shaunfg/MarsRoverElectronics/old-rover/lessr/PDFs/Rover-brd.pdf

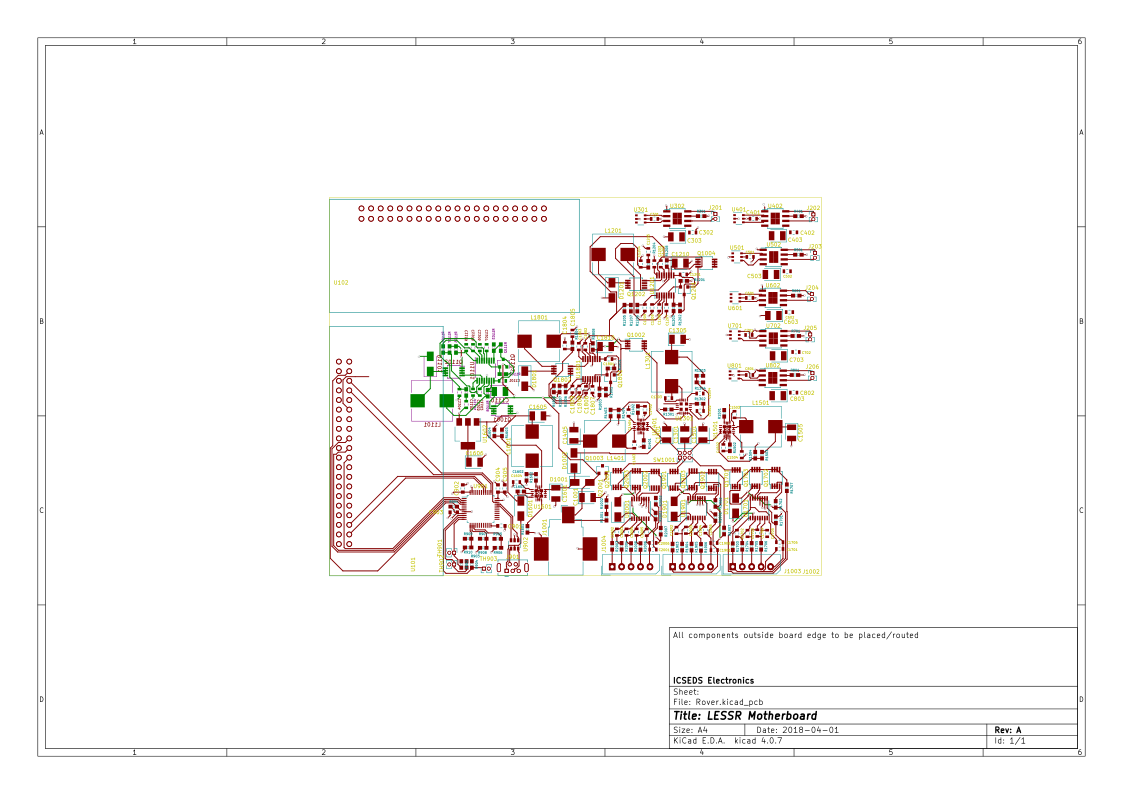
[picture p1: page 1]
