shaunfg/MarsRoverElectronics/Mars Rover.pdf

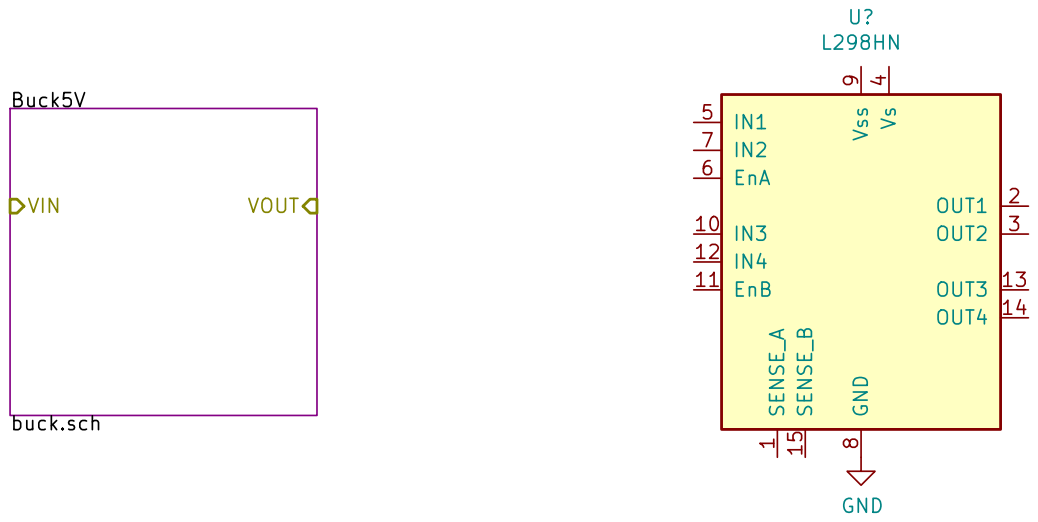
[picture p2: page 1]

Id: 1/2 Title: File: Mars Rover.sch Sheet: / SENSE_A

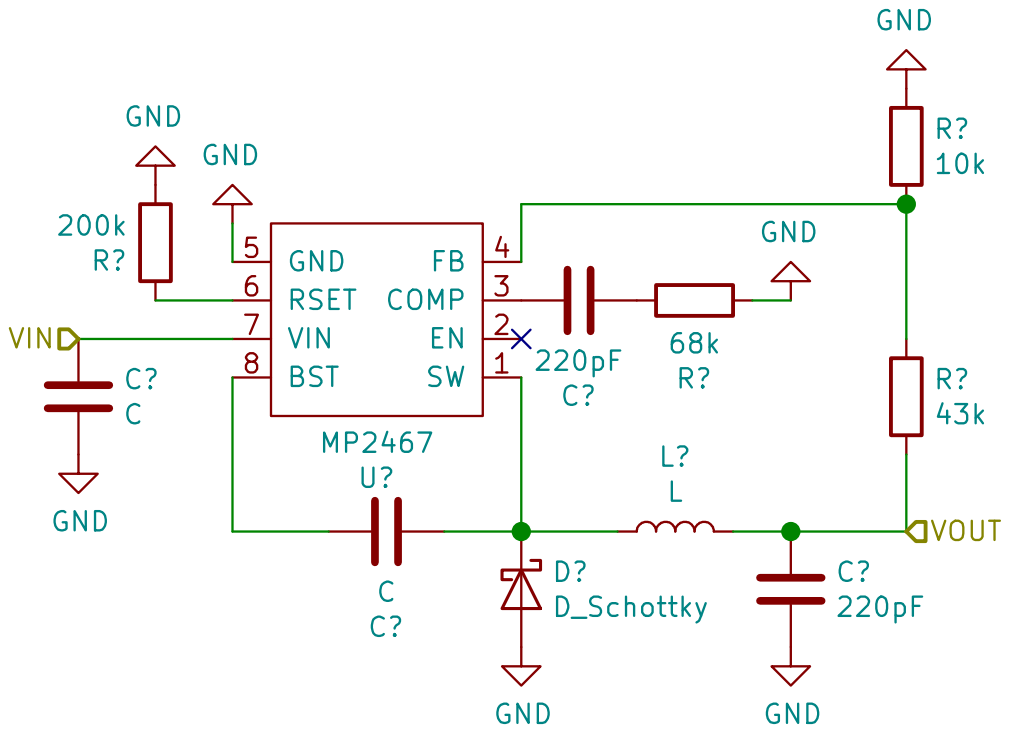
[picture p3: page 2]

Id: 2/2 Title: File: buck.sch Sheet: /Buck5V/
