shaunfg/MarsRoverElectronics/Gerbplots/Mars Rover-F.Cu.pdf

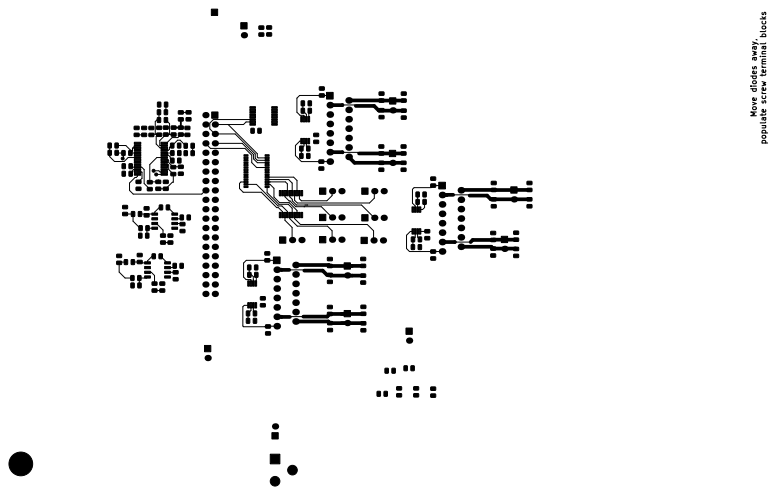
[picture p4: page 1]

Move diodes away, populate screw terminal blocks
