shaunfg/MarsRoverElectronics/Gerbplots/Mars Rover-B.Cu.pdf

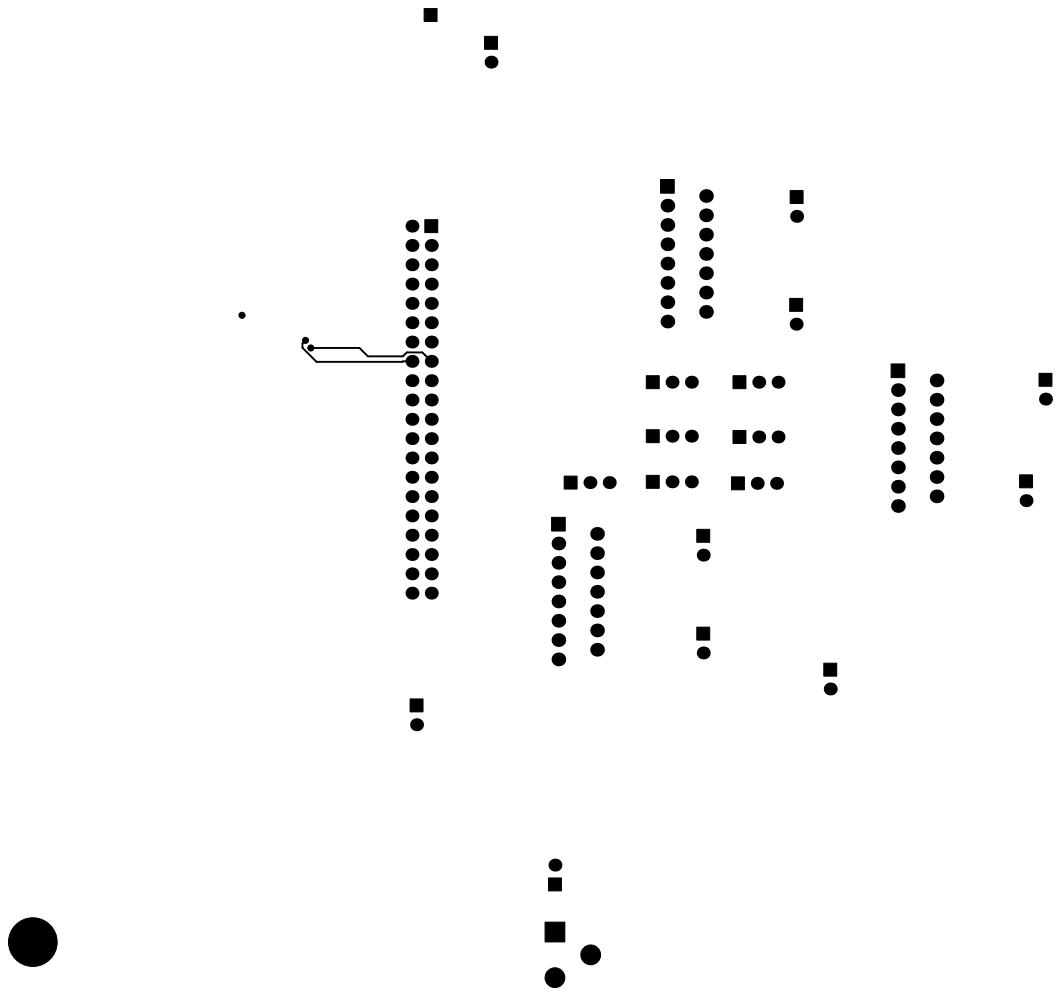
[picture p5: page 1]
