shaunfg/MarsRoverElectronics/Gerbplots/Mars Rover-B.Mask.pdf

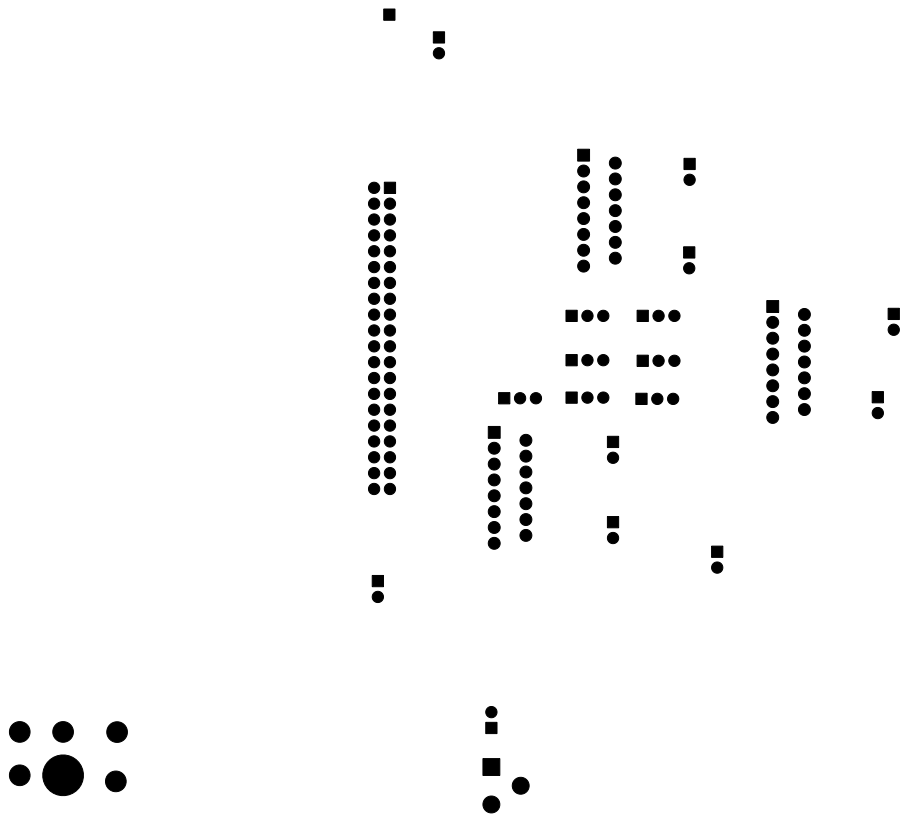
[picture p6: page 1]
