shaunfg/MarsRoverElectronics/Gerbplots/Mars Rover-F.Mask.pdf

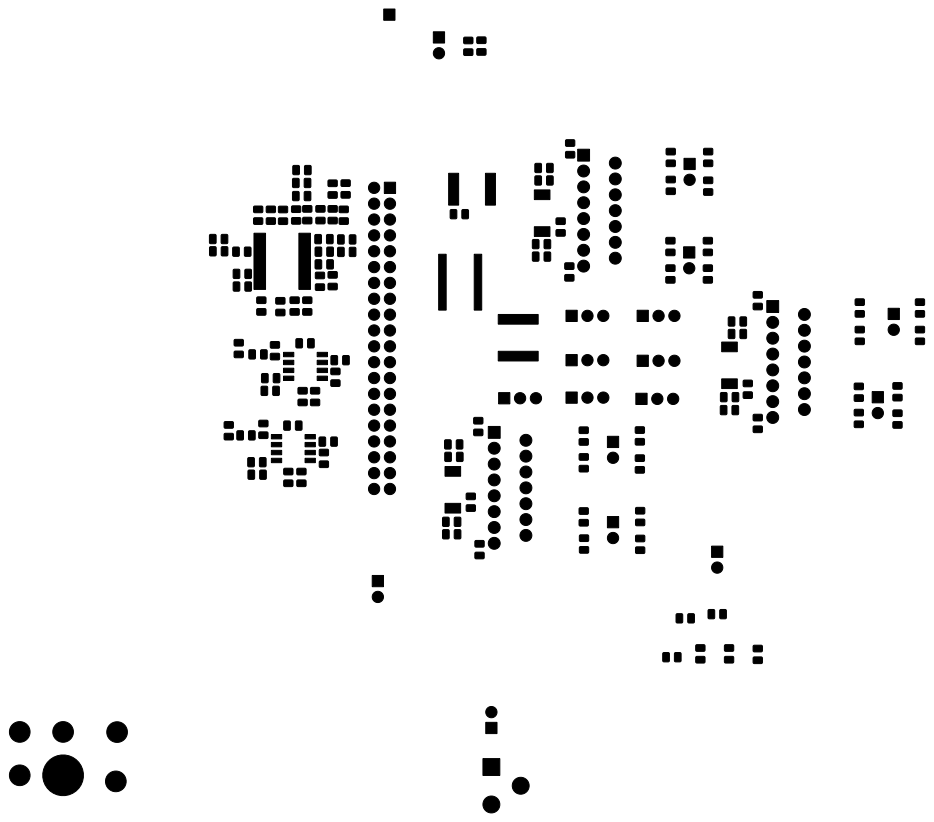
[picture p7: page 1]
