shaunfg/MarsRoverElectronics/Gerbplots/Mars Rover-F.Paste.pdf

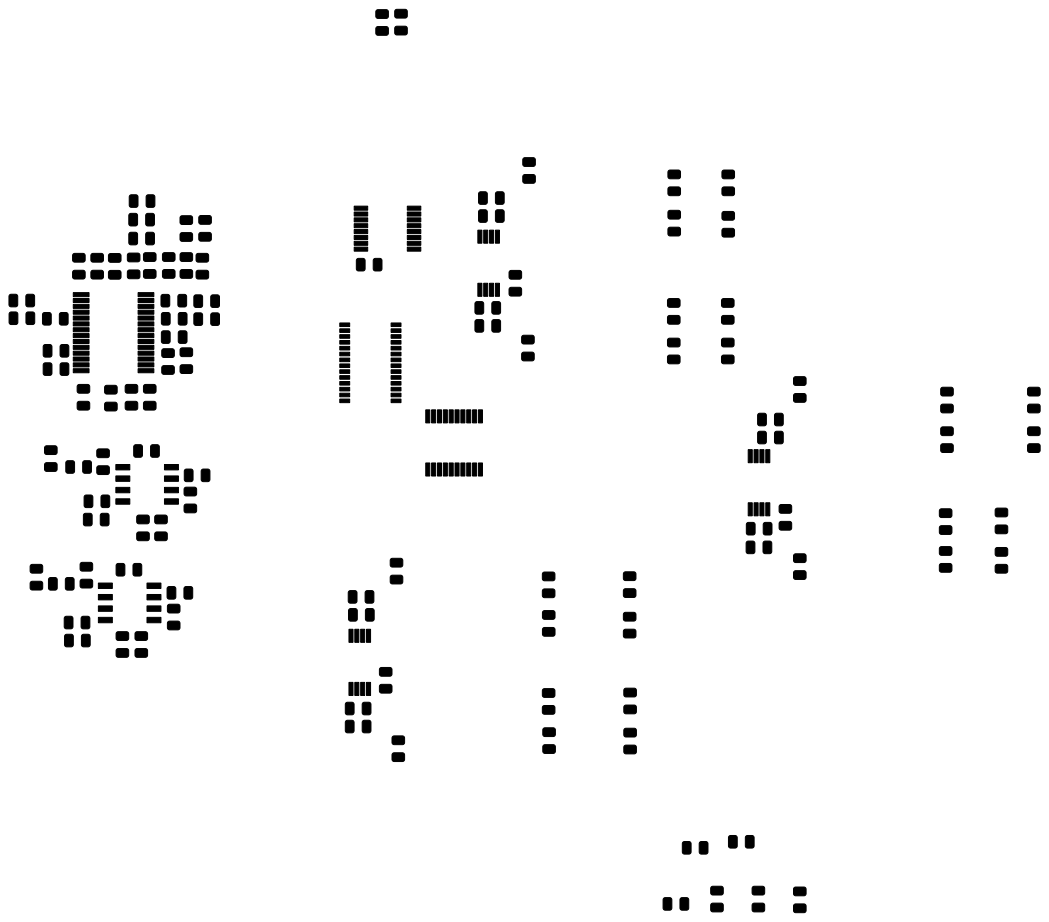
[picture p8: page 1]
