shaunfg/MarsRoverElectronics/Gerbplots/Mars Rover-F.SilkS.pdf

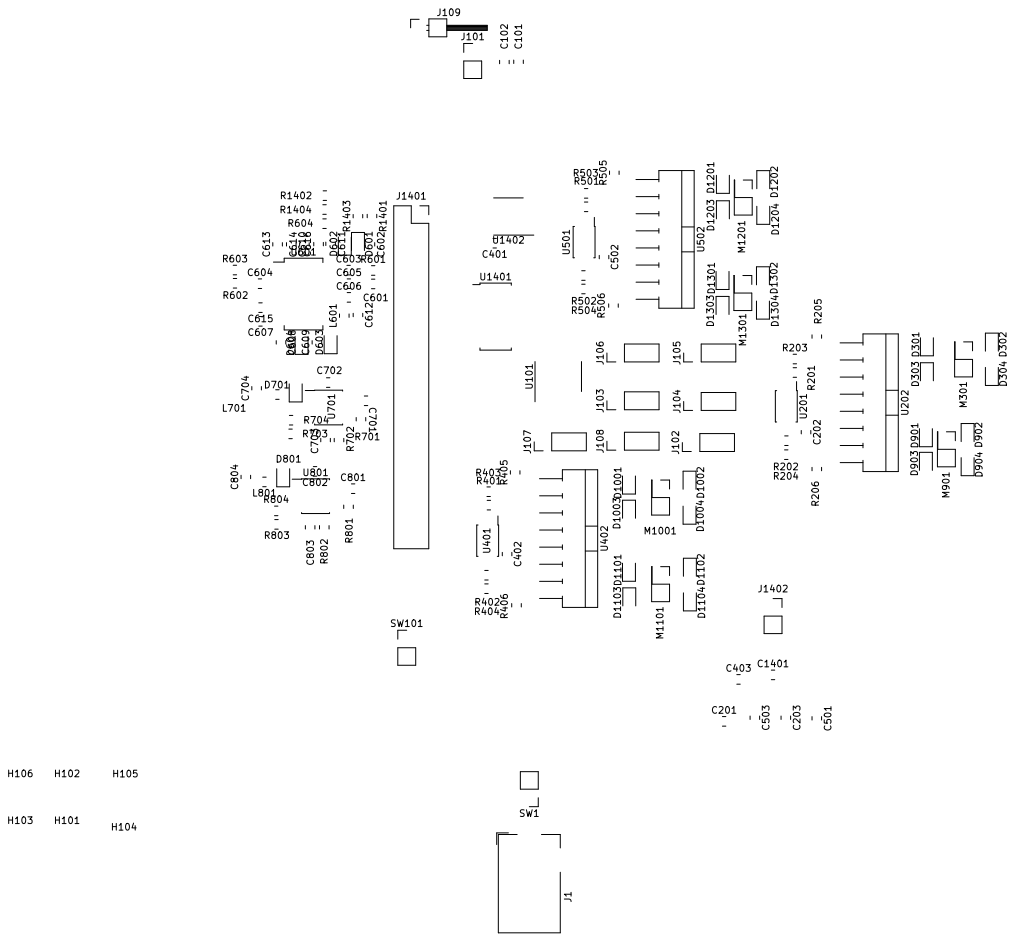
[picture p9: page 1]
