shaunfg/MarsRoverElectronics/old-rover/lessr/PDFs/layout.pdf

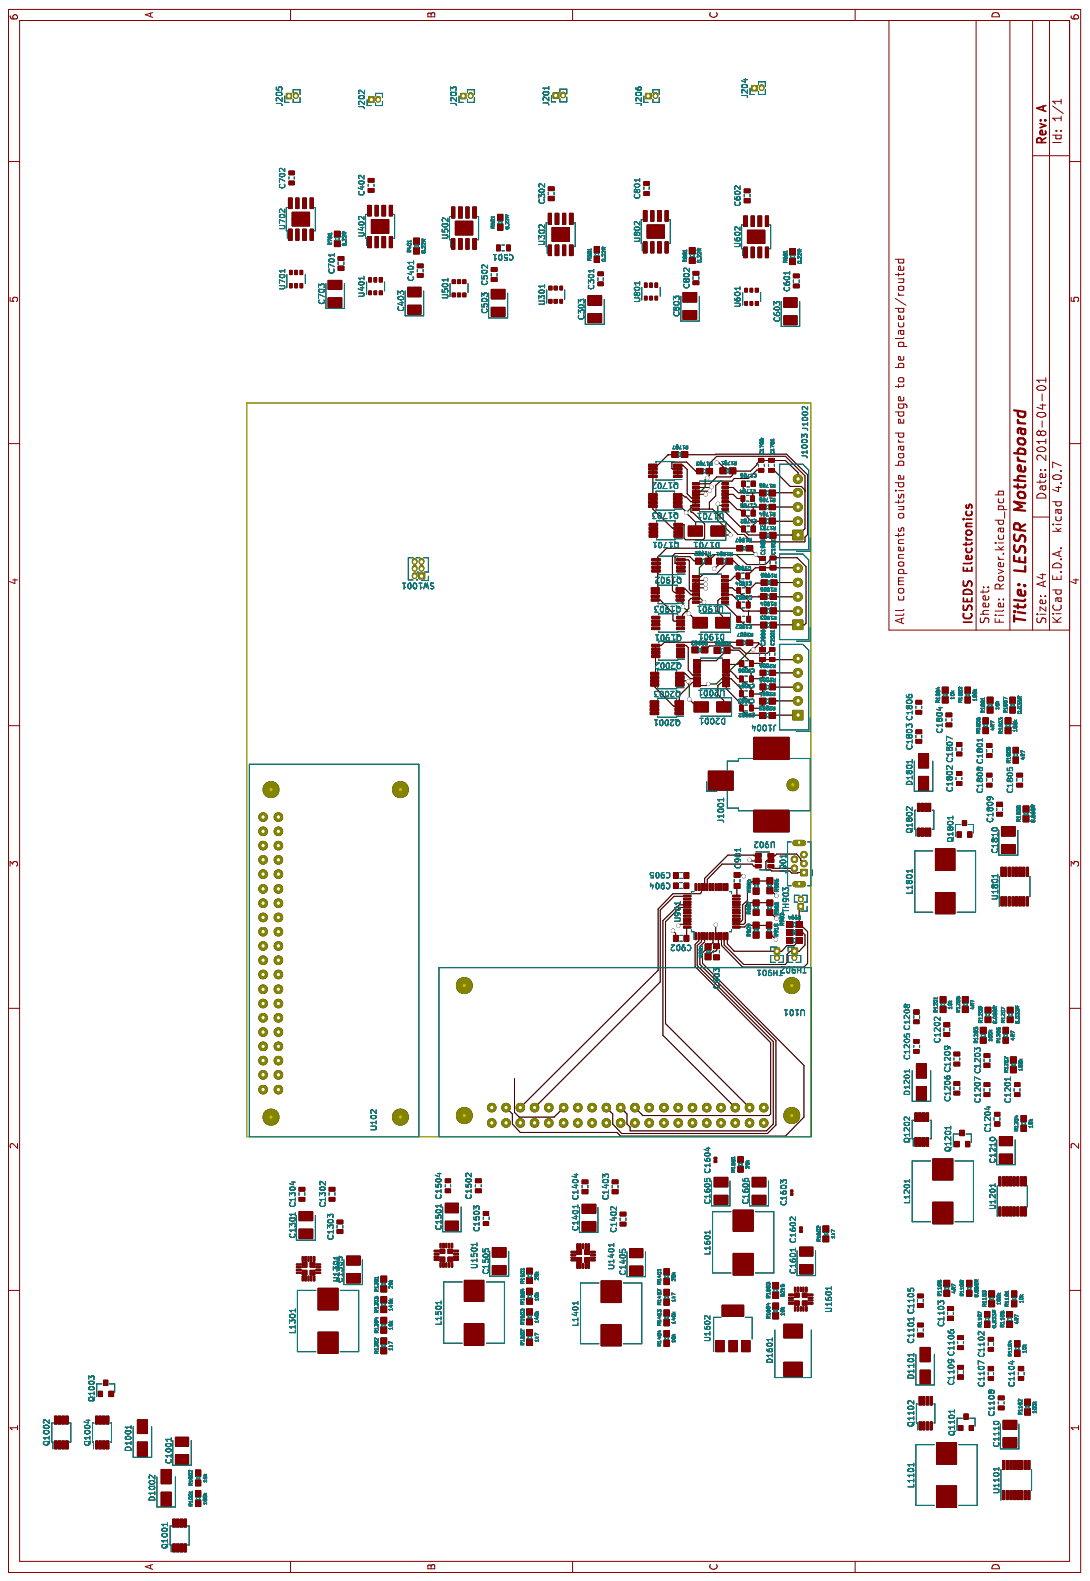
[picture p10: page 1]
