shaunfg/MarsRoverElectronics/old-rover/lessr/PDFs/Rover-B.Cu.pdf

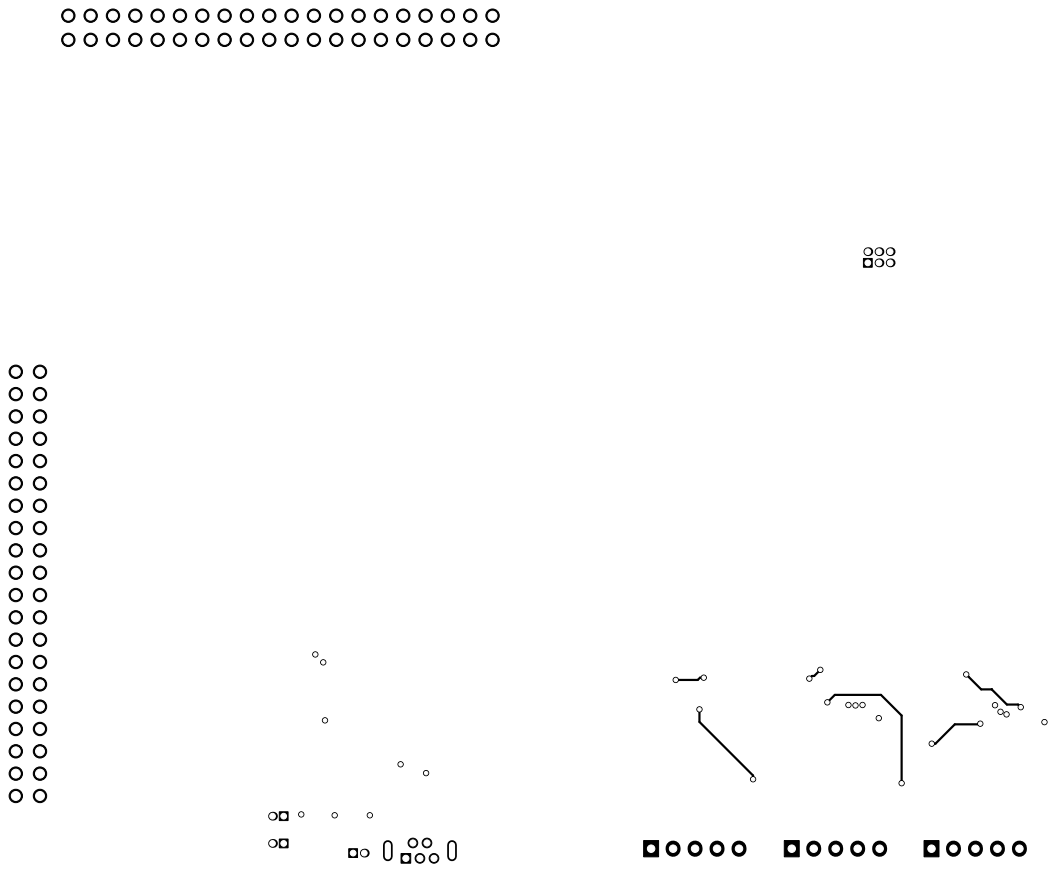
[picture p11: page 1]
