shaunfg/MarsRoverElectronics/old-rover/lessr/PDFs/Rover-Dwgs.User.pdf

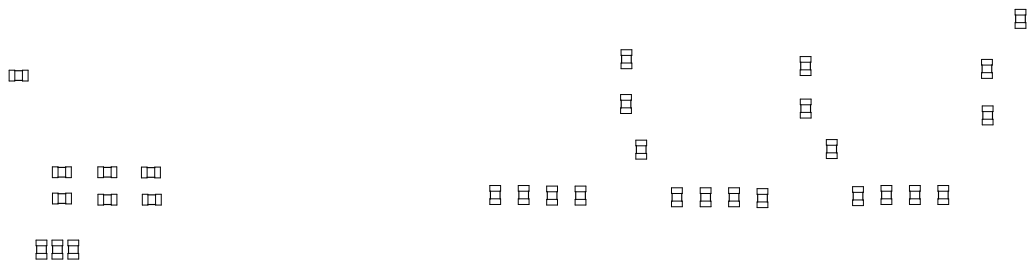
[picture p12: page 1]
