shaunfg/MarsRoverElectronics/old-rover/lessr/PDFs/Rover-F.Cu.pdf

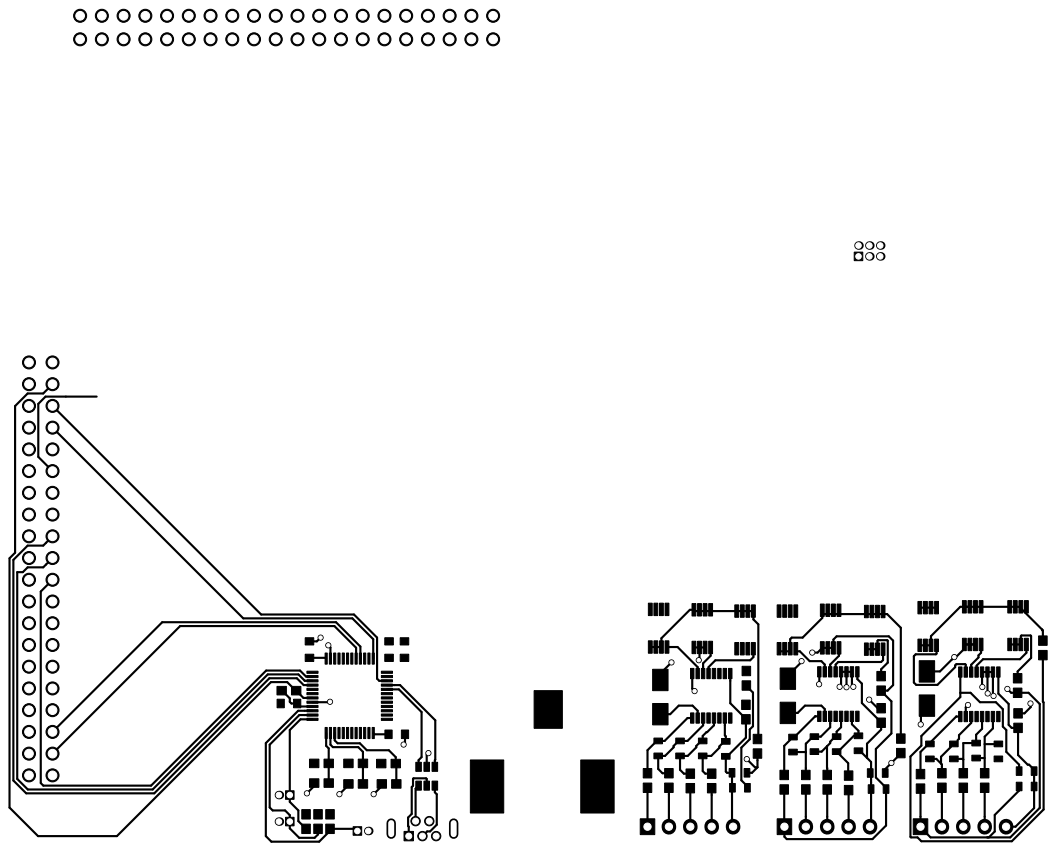
[picture p13: page 1]
