shaunfg/MarsRoverElectronics/old-rover/lessr/PDFs/Rover-F.SilkS.pdf

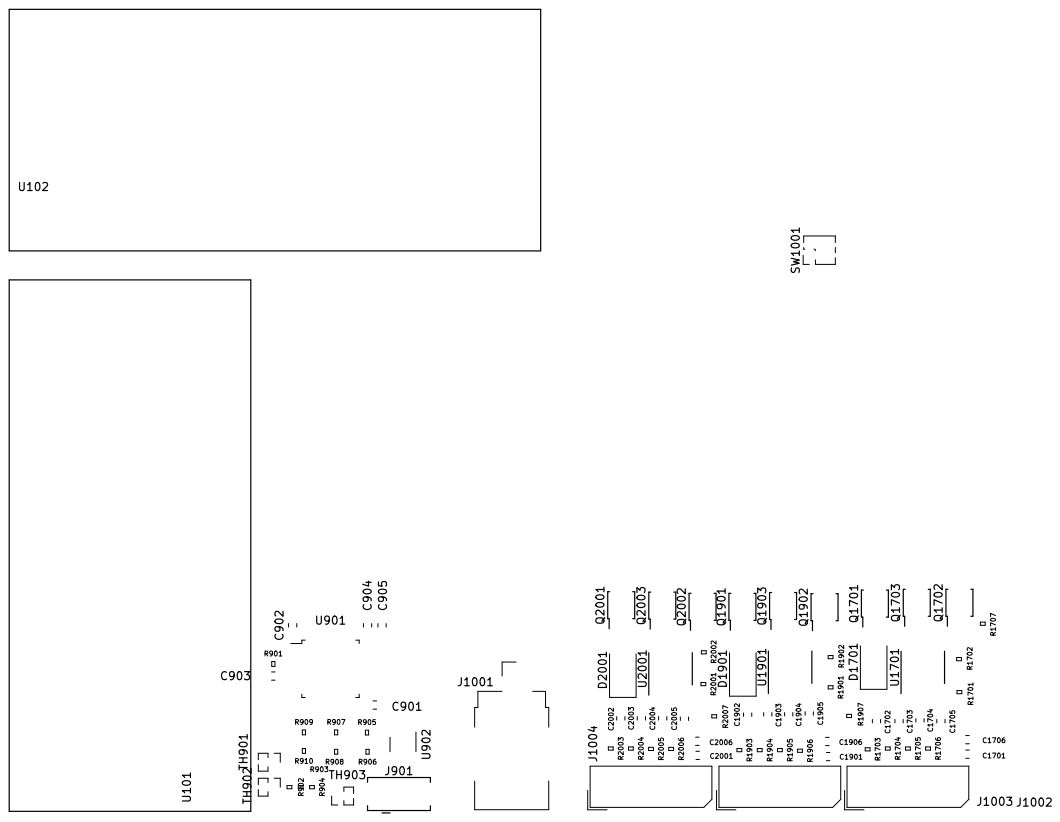
[picture p14: page 1]
