shaunfg/MarsRoverElectronics/old-rover/lessr/PDFs/Rover.pdf

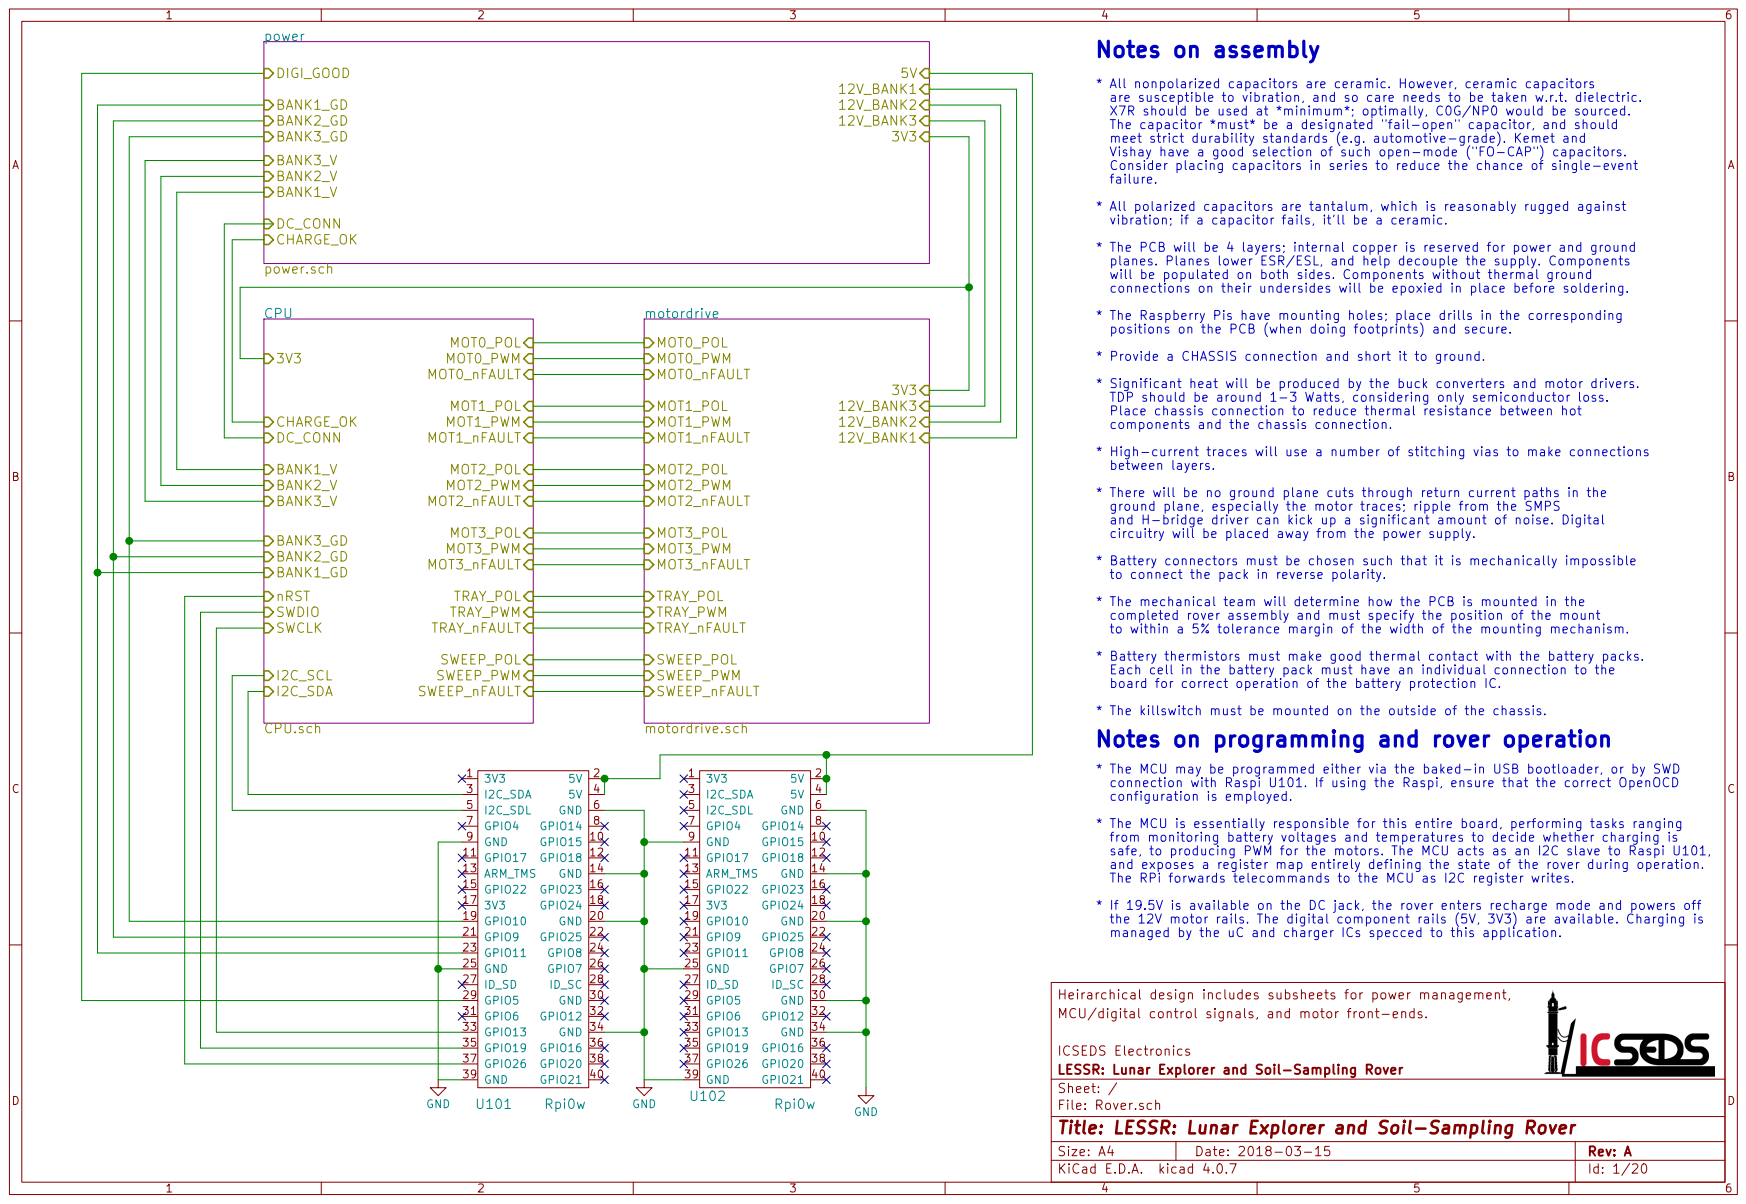
[picture p15: page 1]

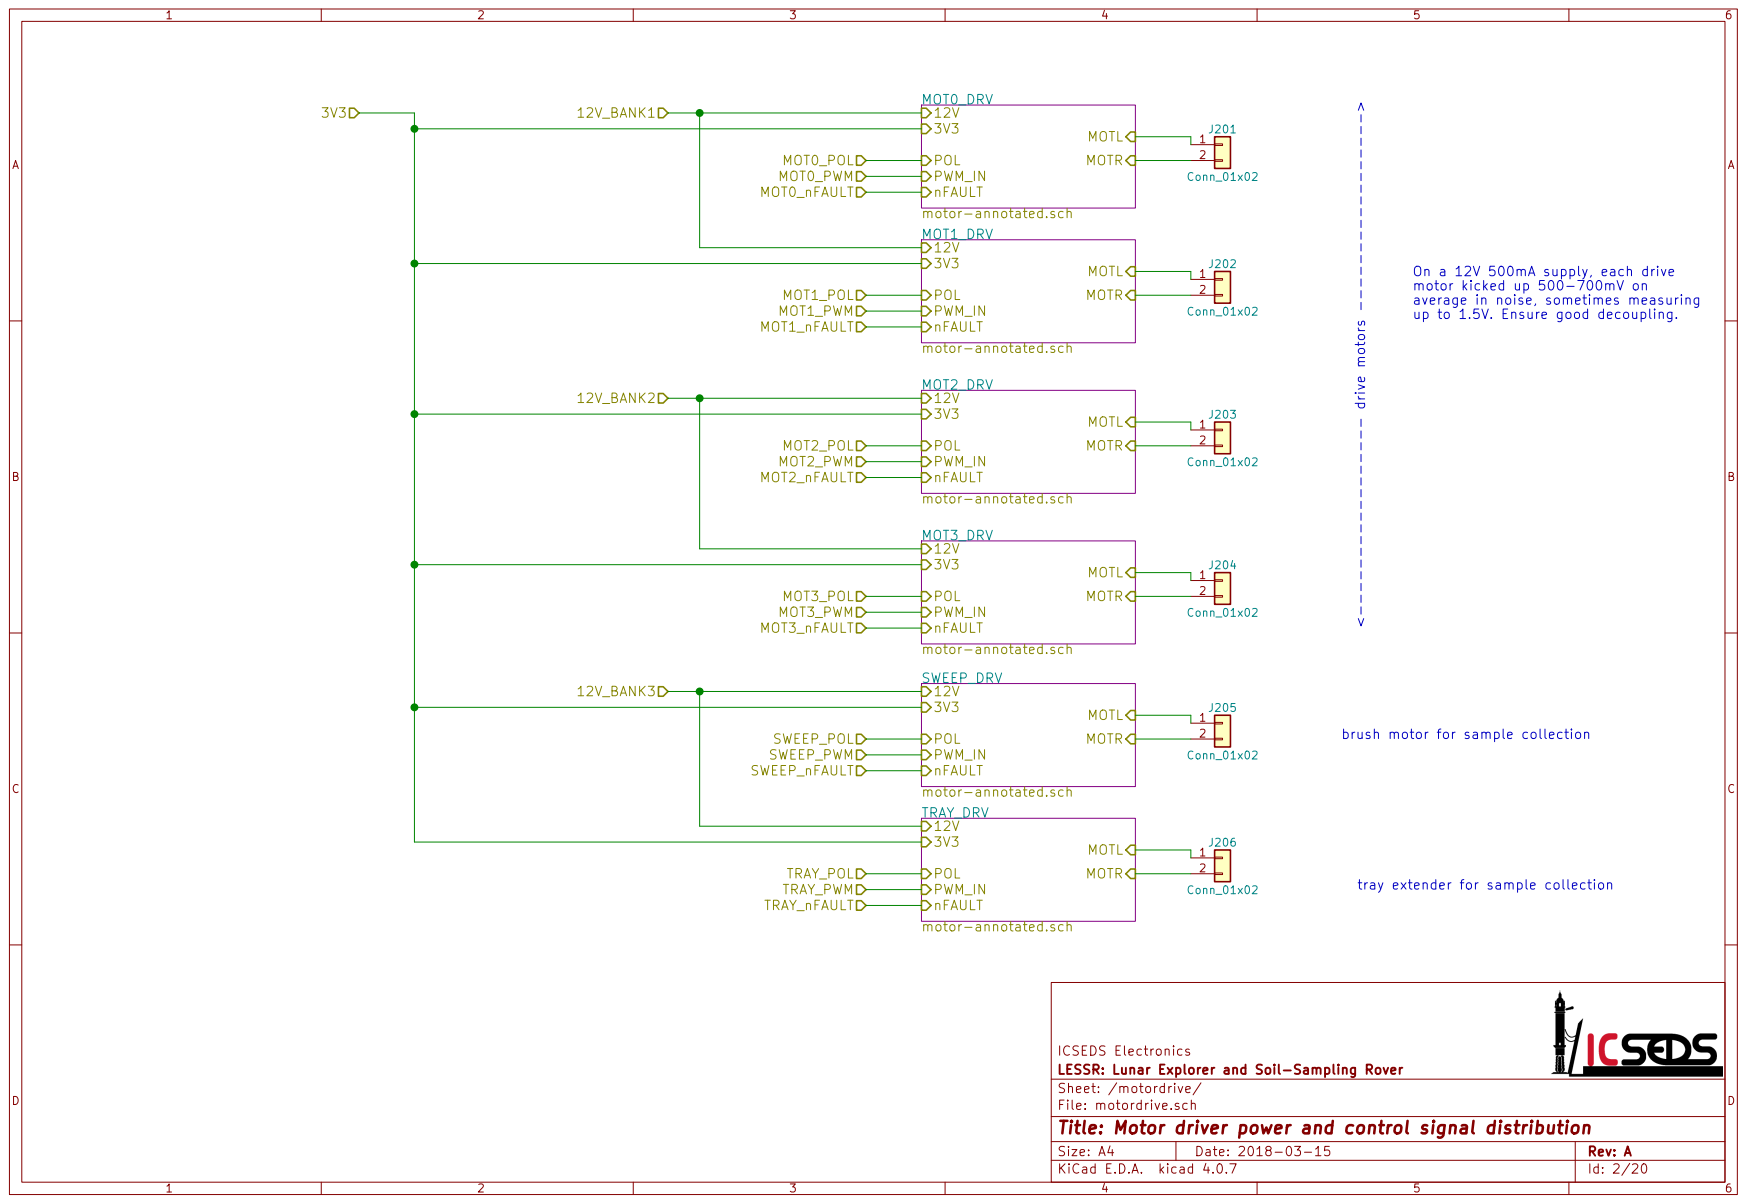
[picture p16: page 2]

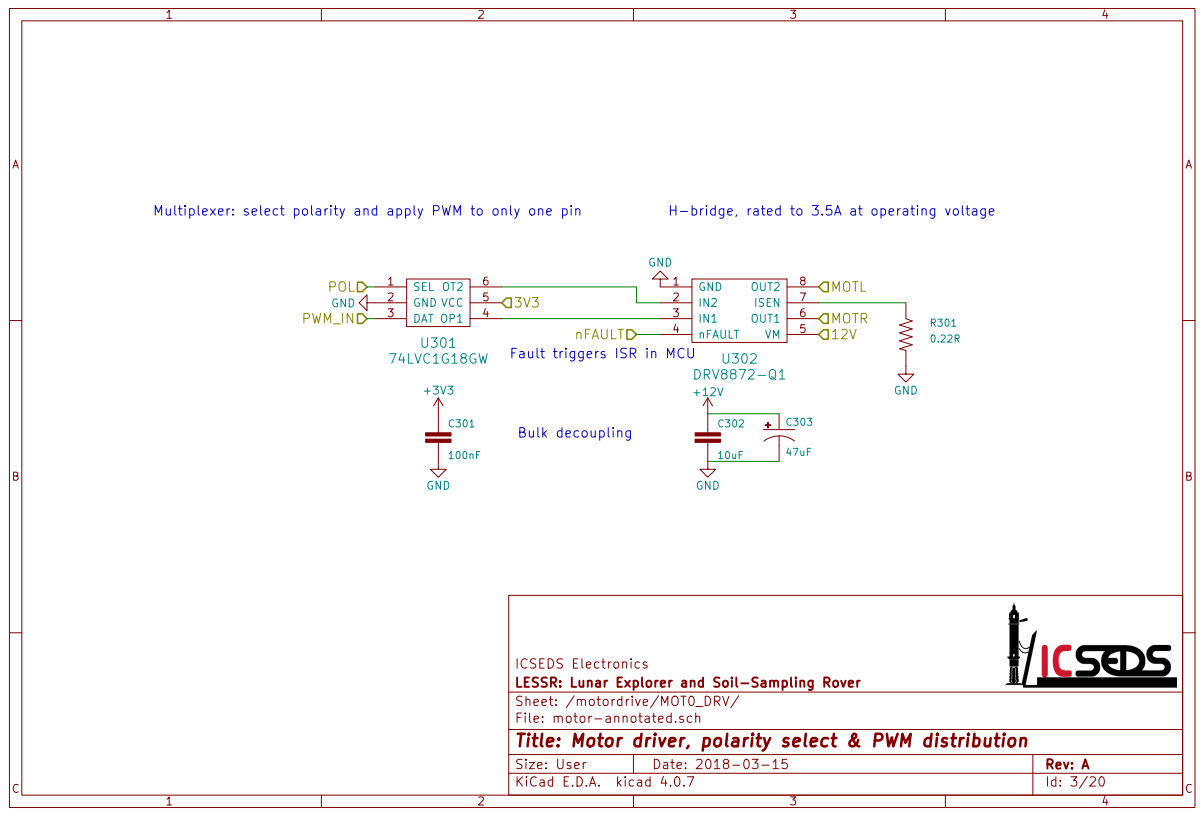
[picture p17: page 3]

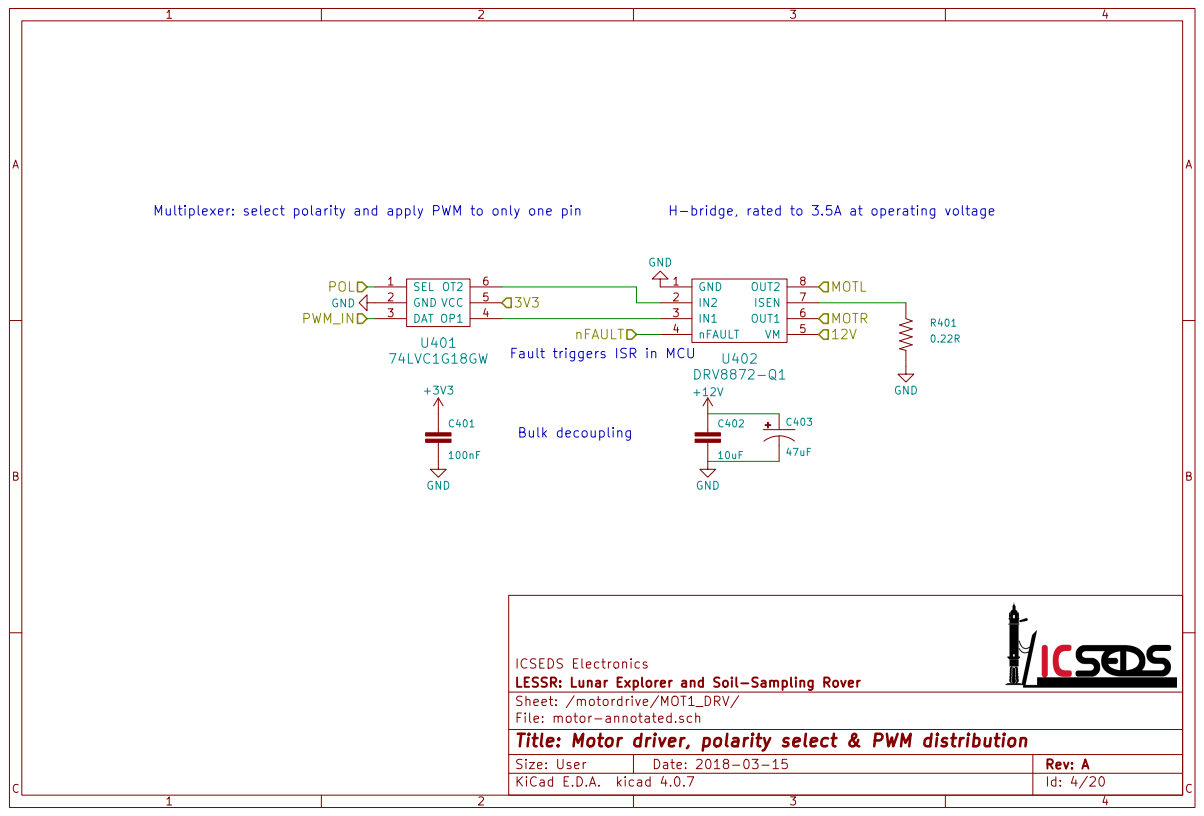
[picture p18: page 4]

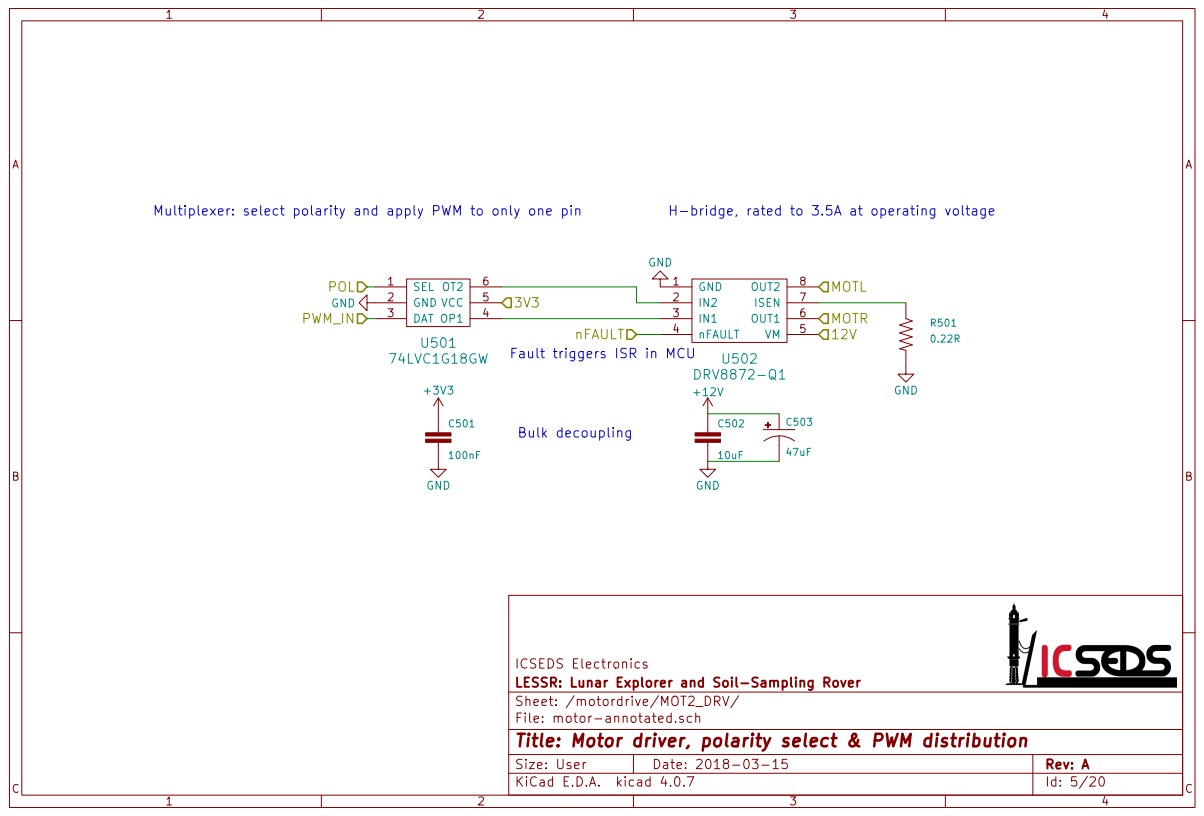
[picture p19: page 5]

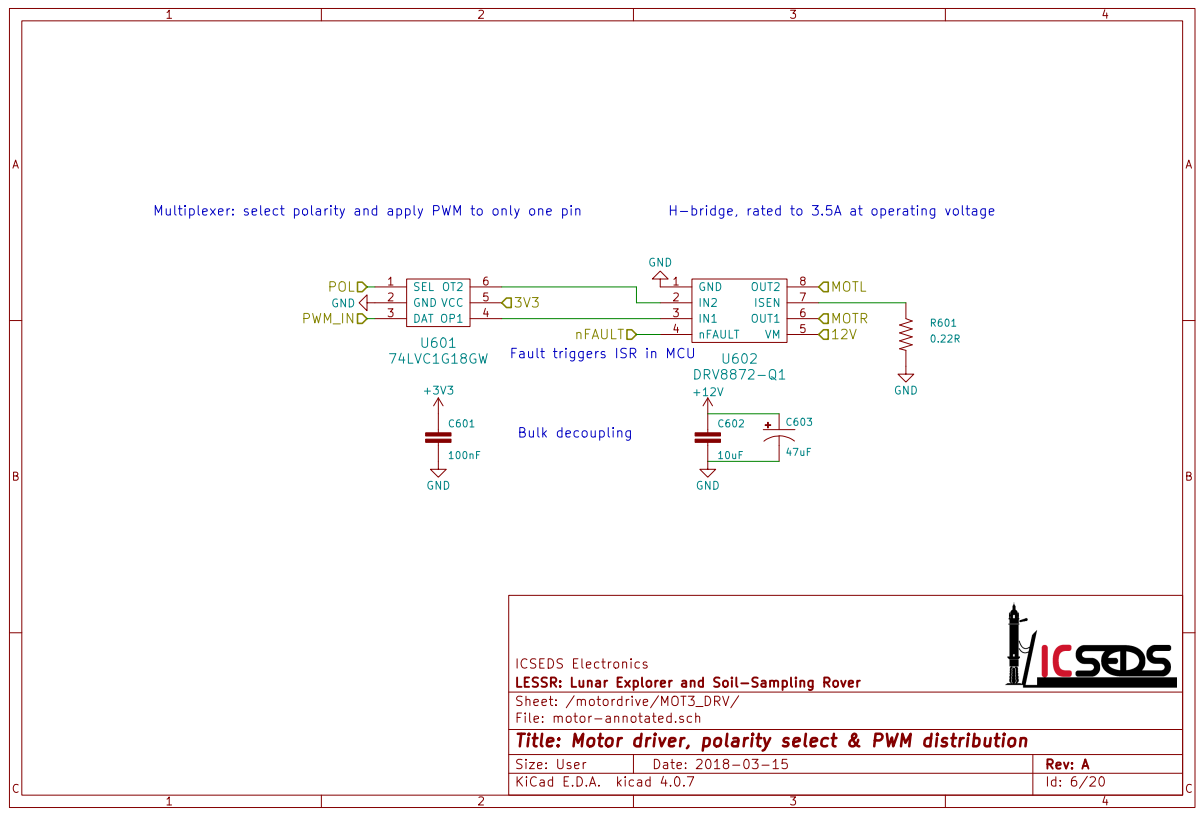
[picture p20: page 6]

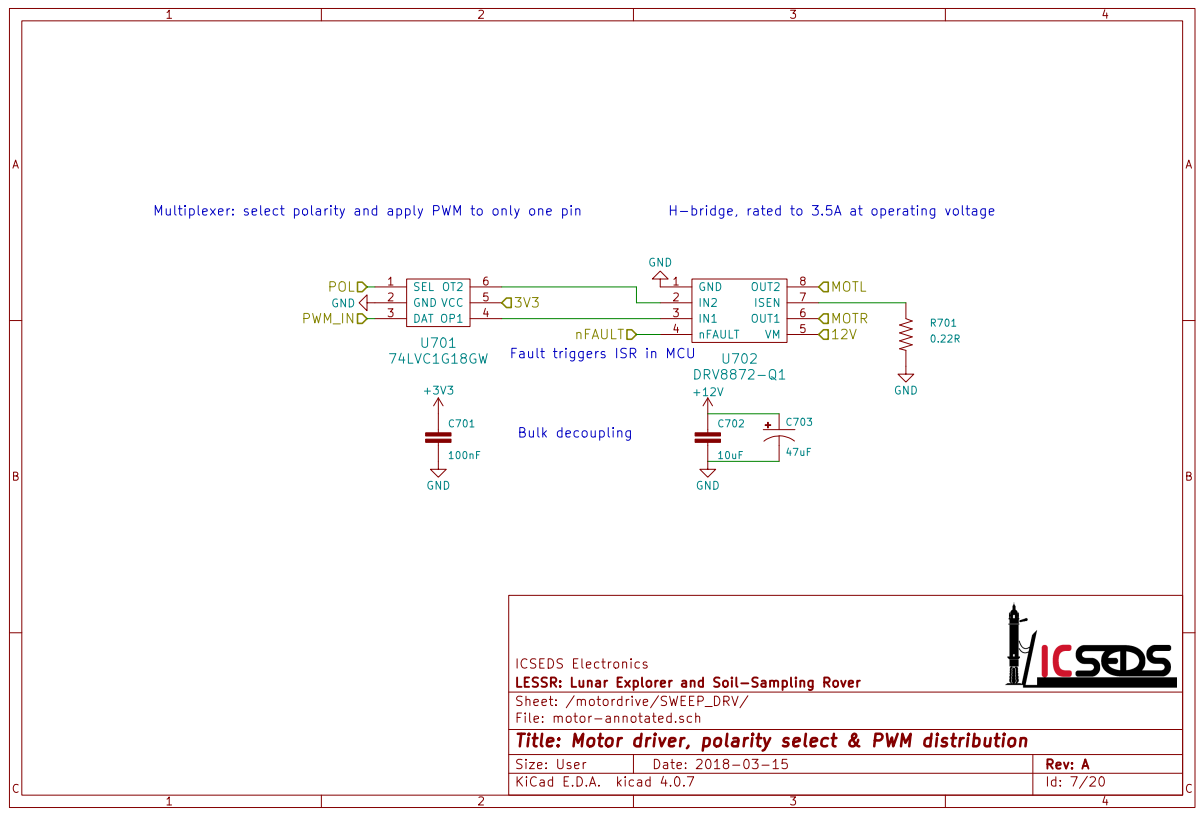
[picture p21: page 7]

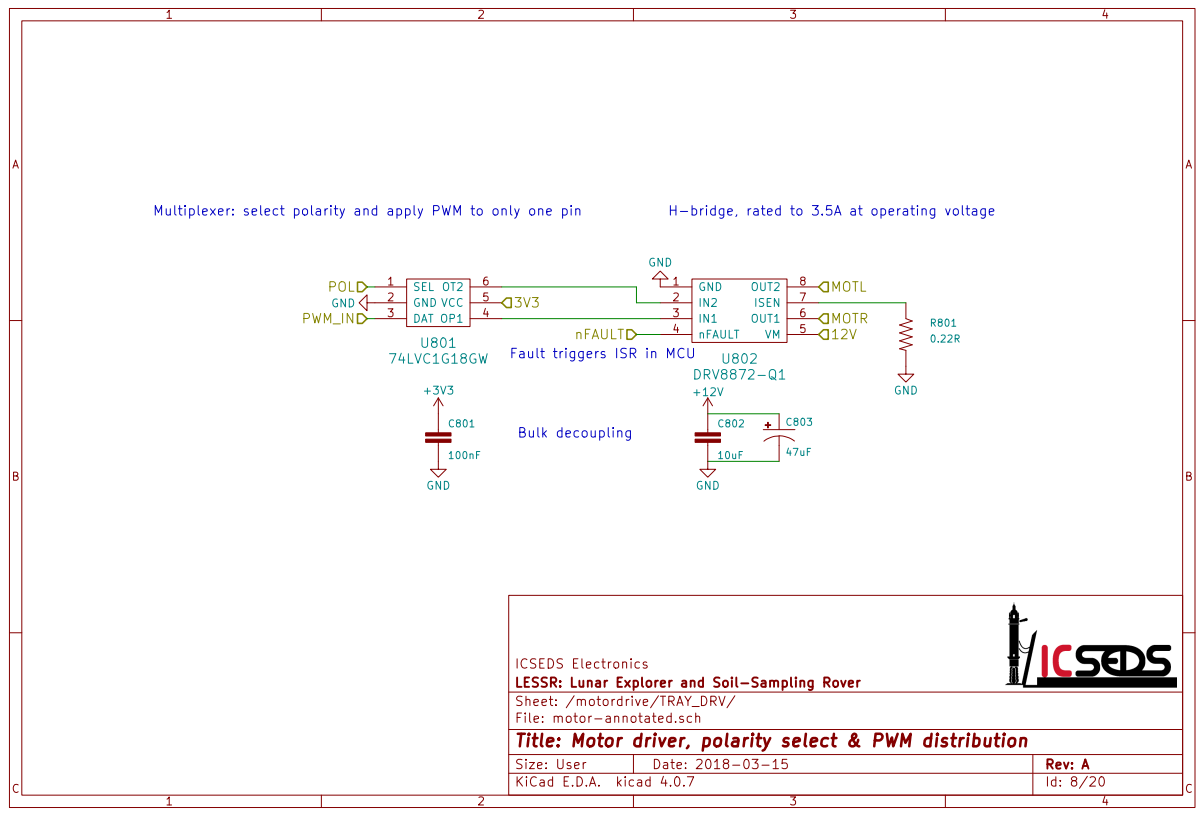
[picture p22: page 8]

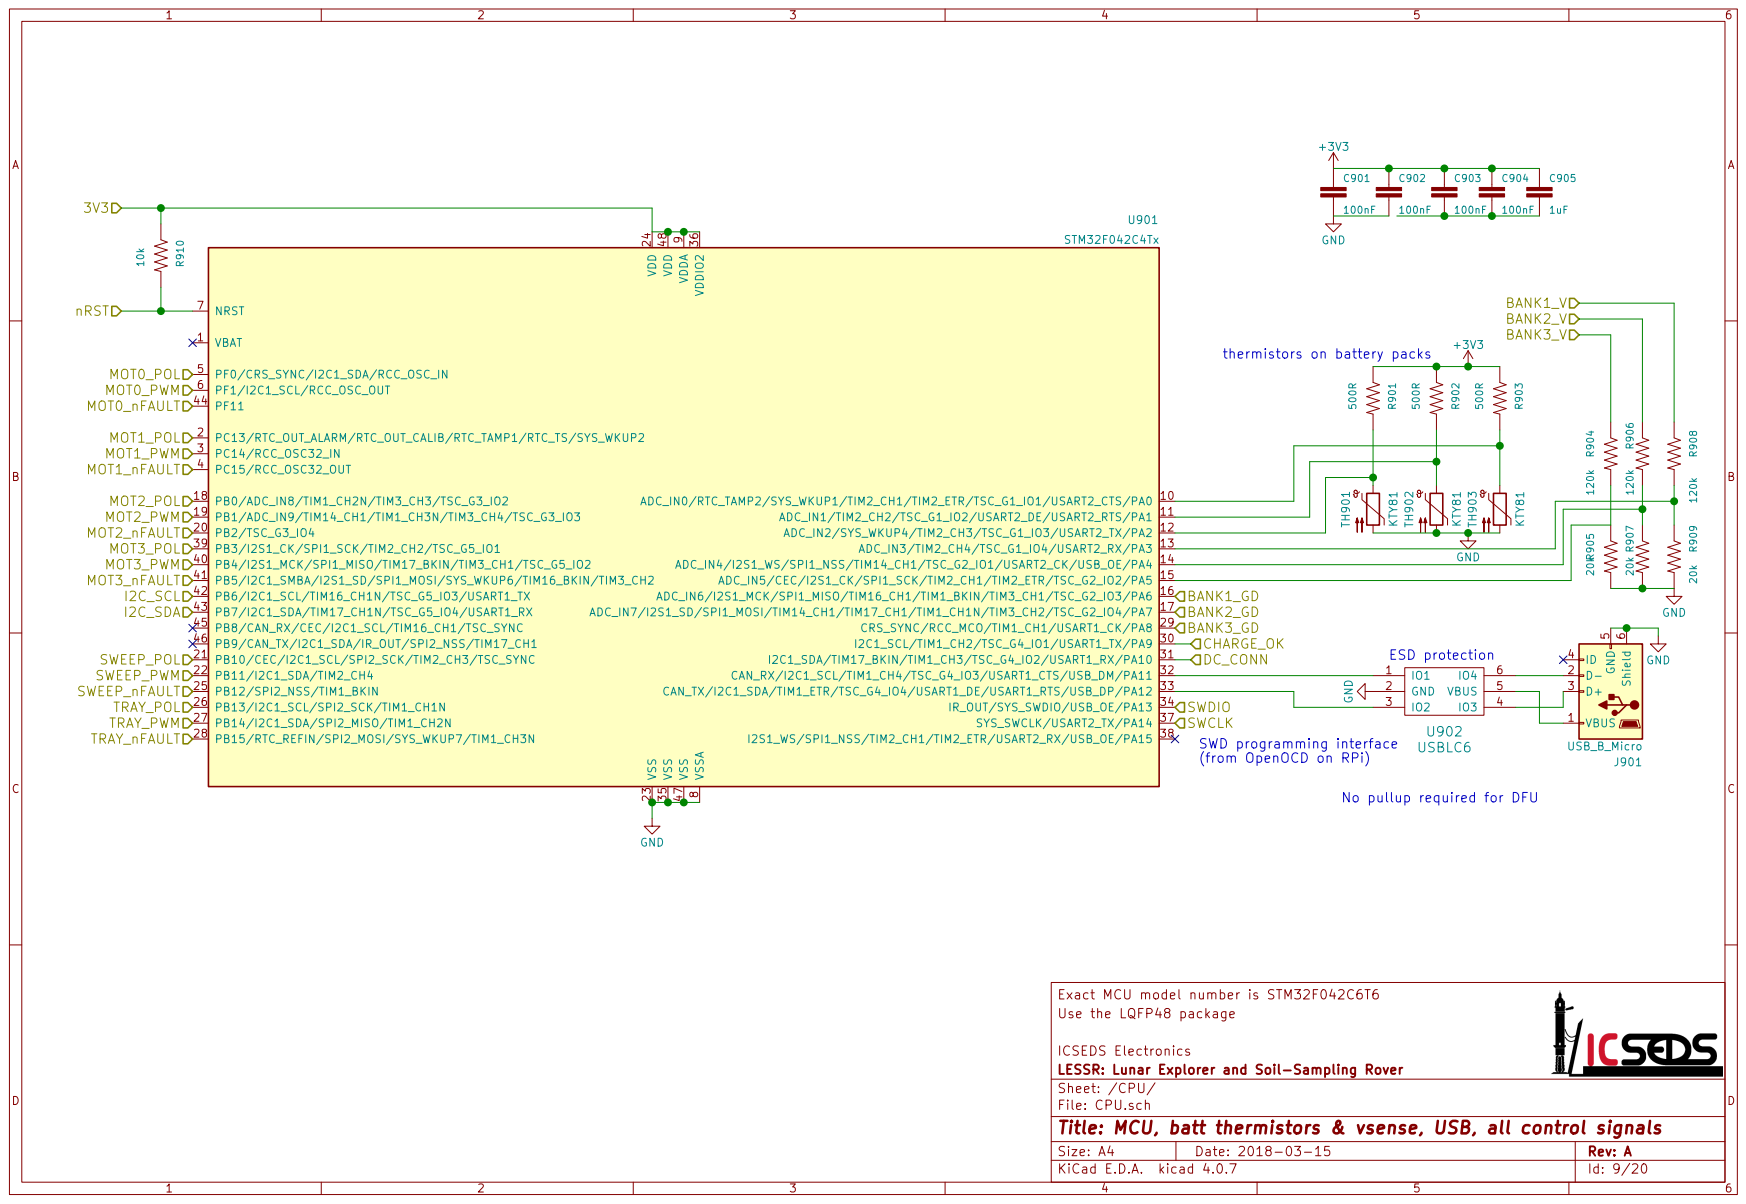
[picture p23: page 9]

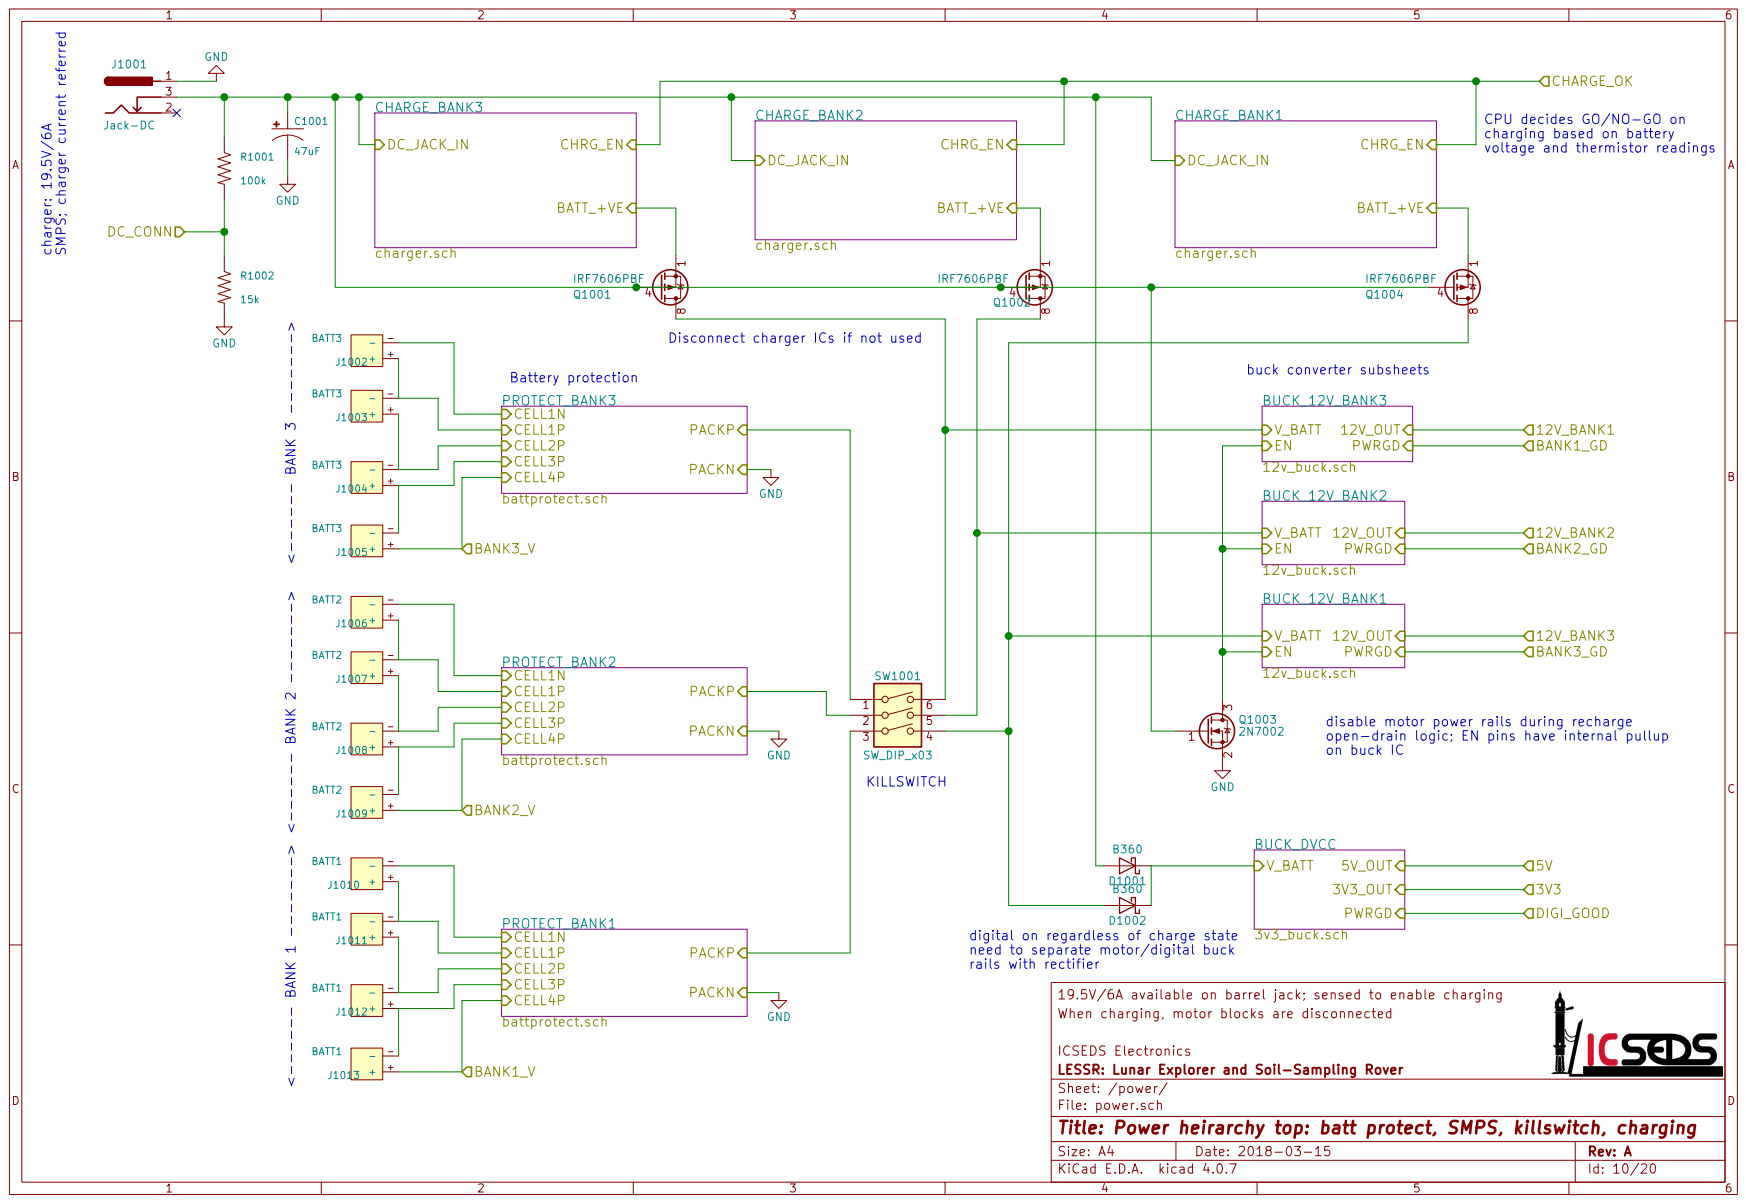
[picture p24: page 10]

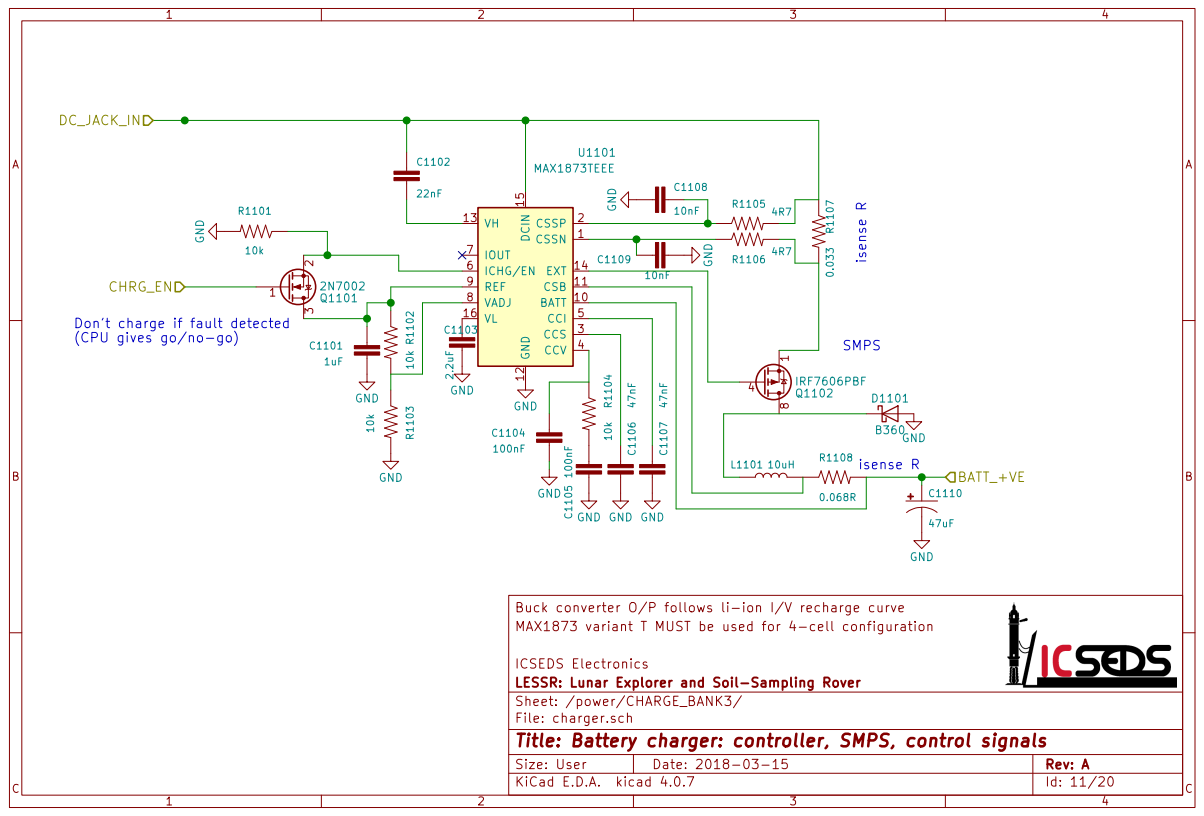
[picture p25: page 11]

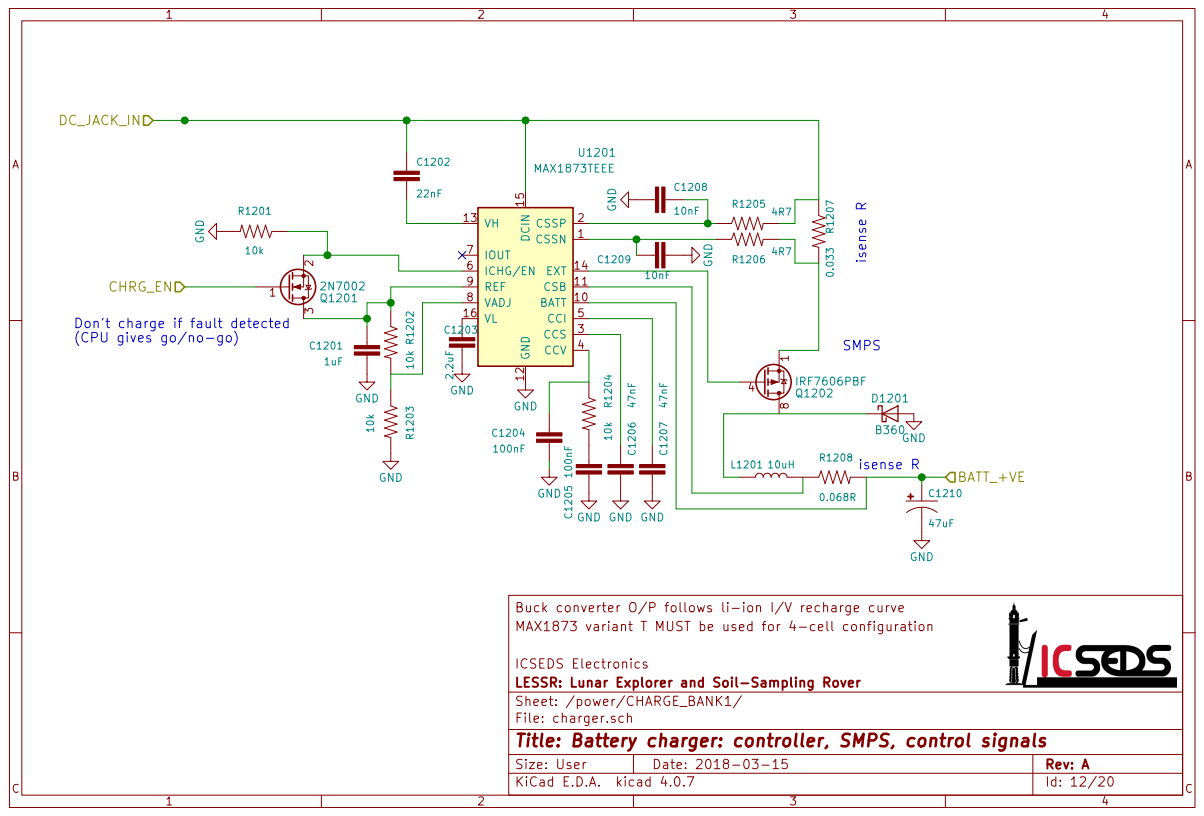
[picture p26: page 12]

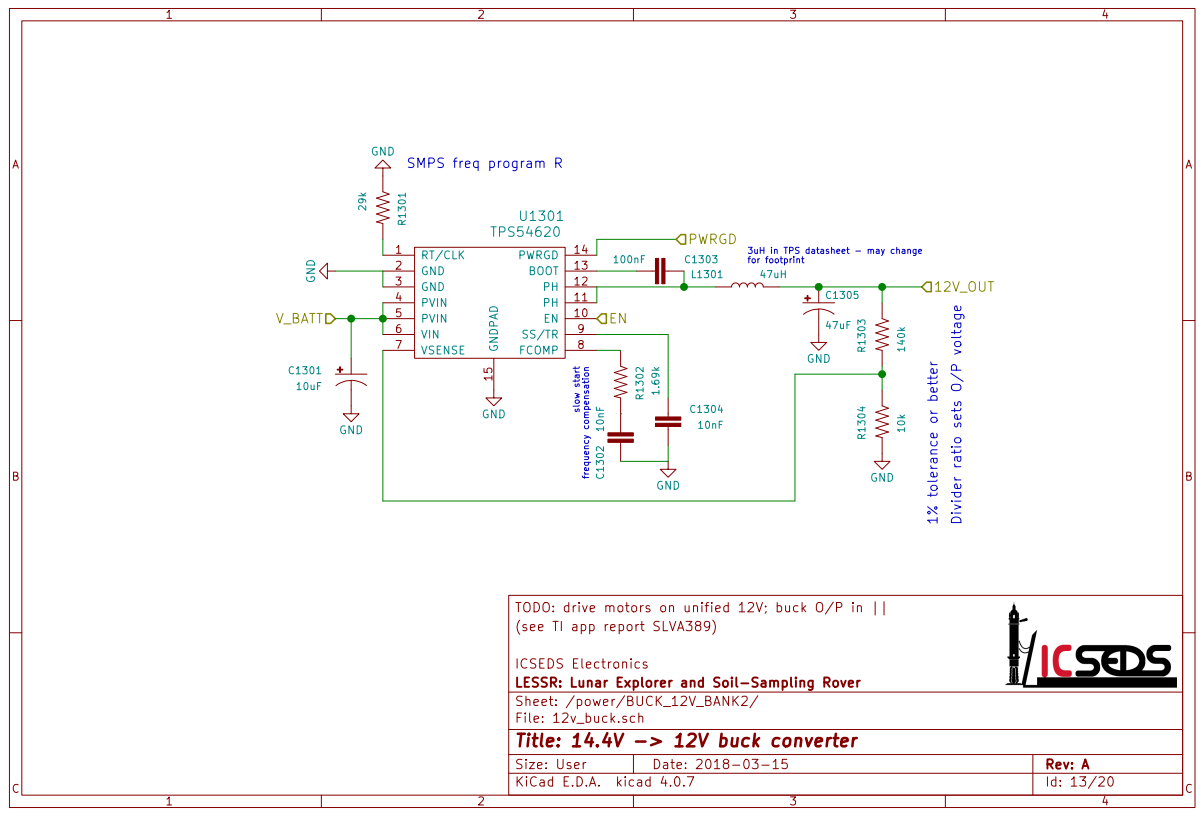
[picture p27: page 13]

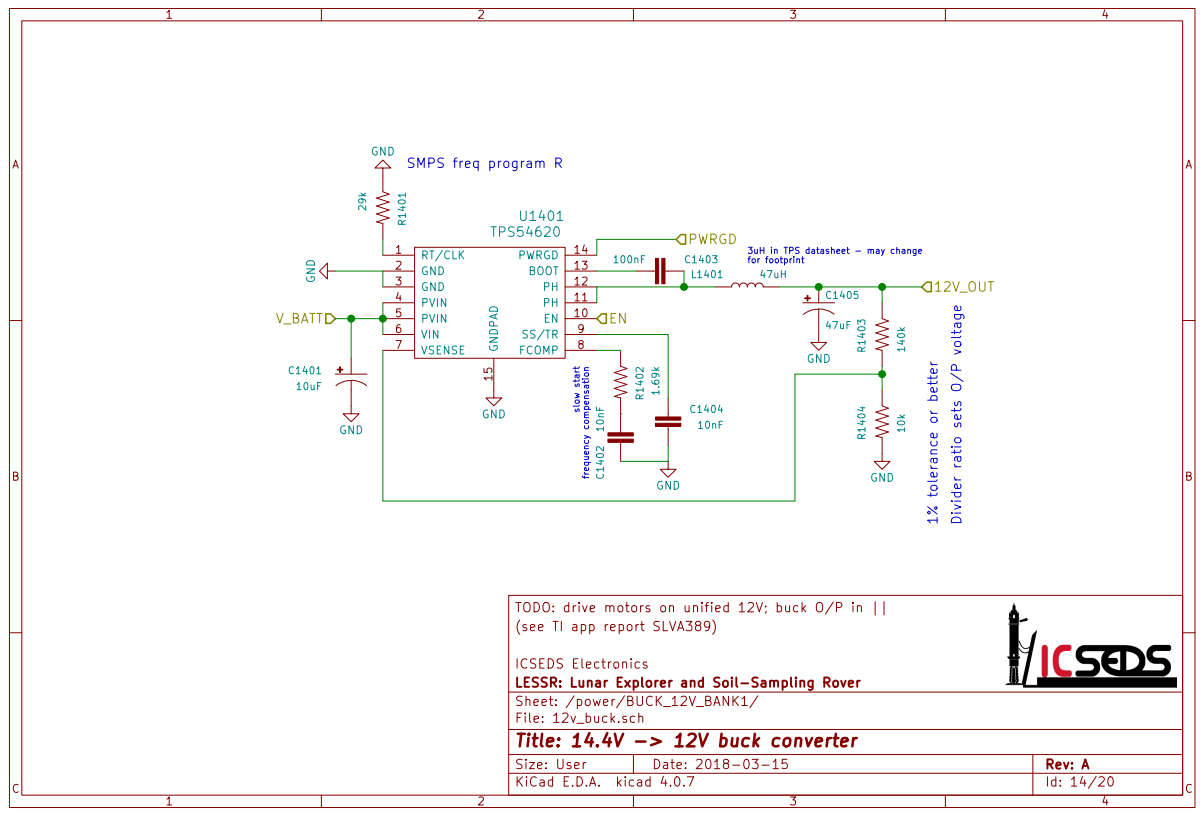
[picture p28: page 14]

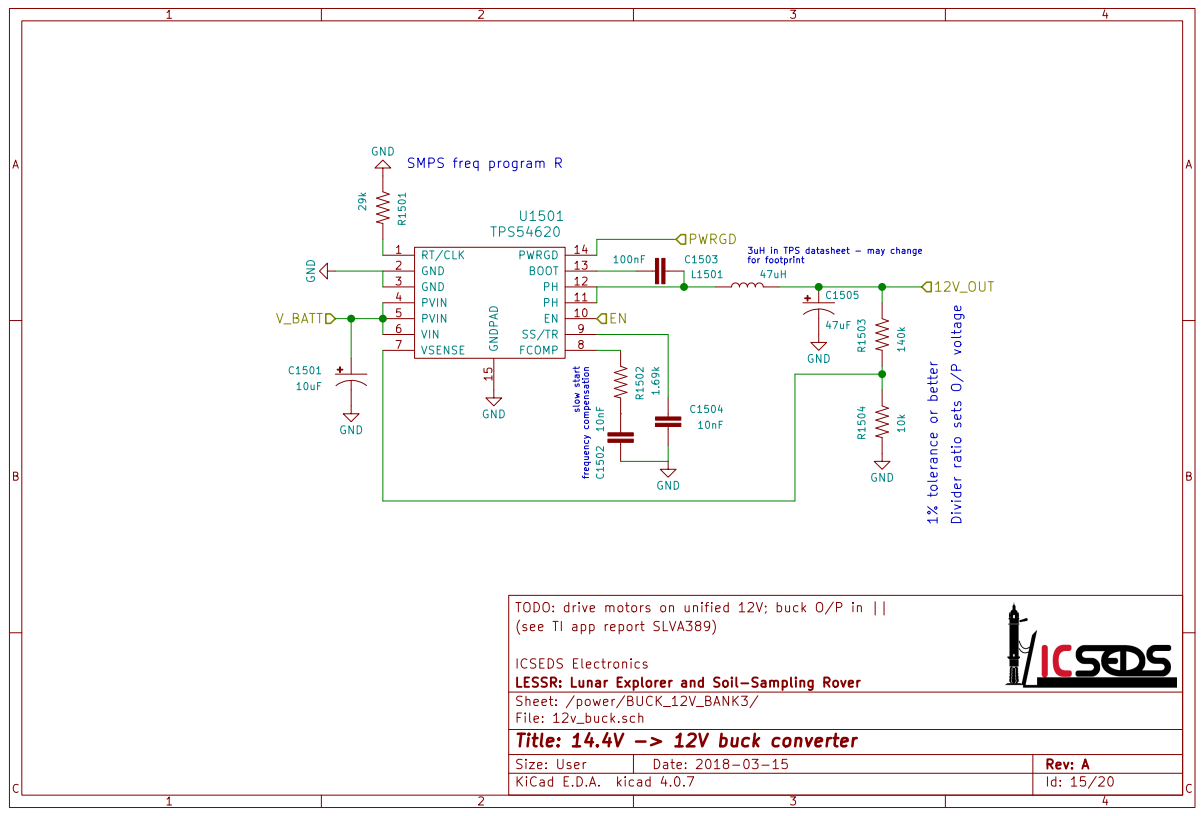
[picture p29: page 15]

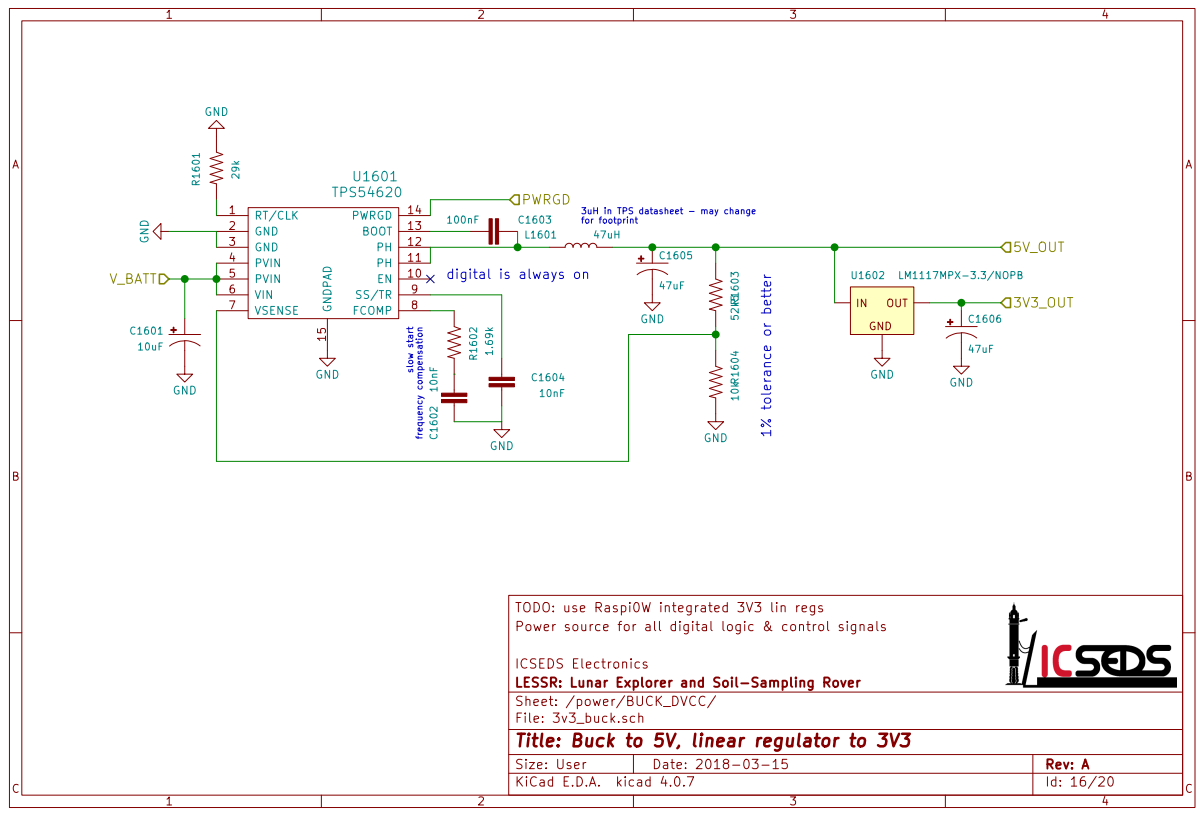
[picture p30: page 16]

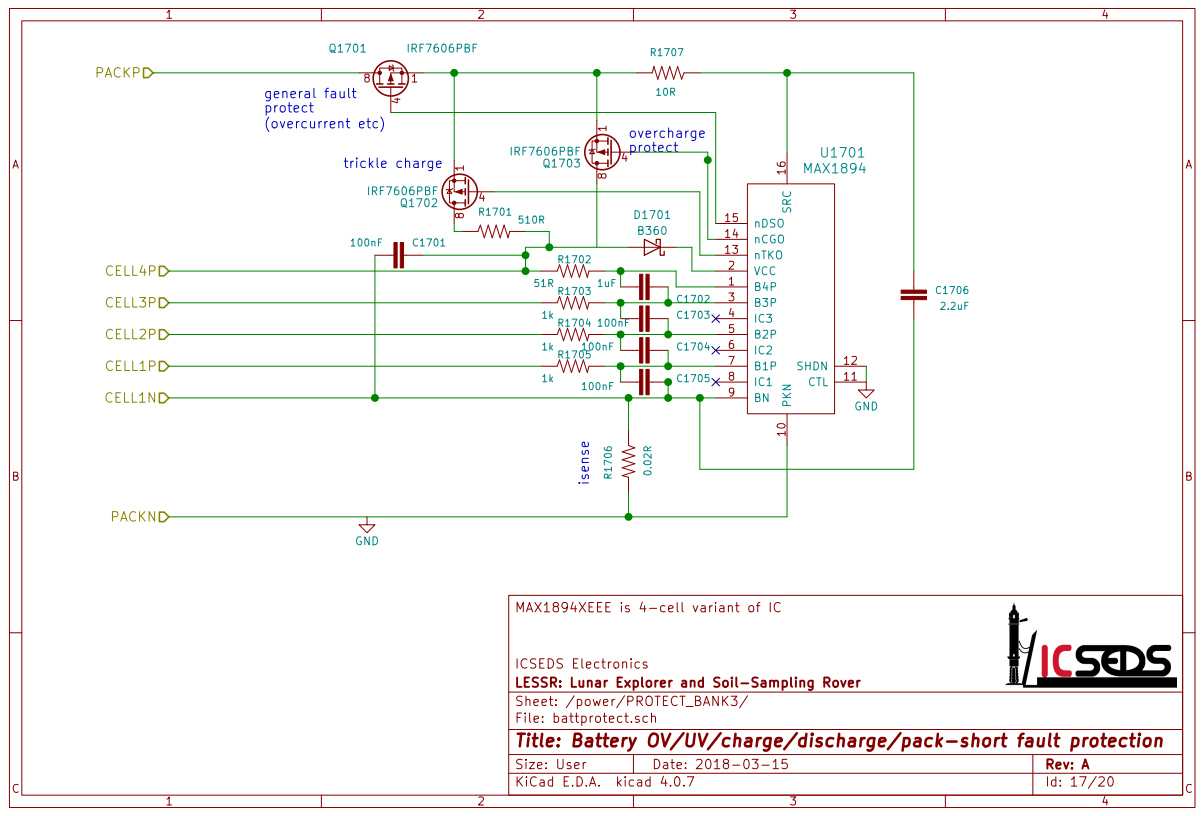
[picture p31: page 17]

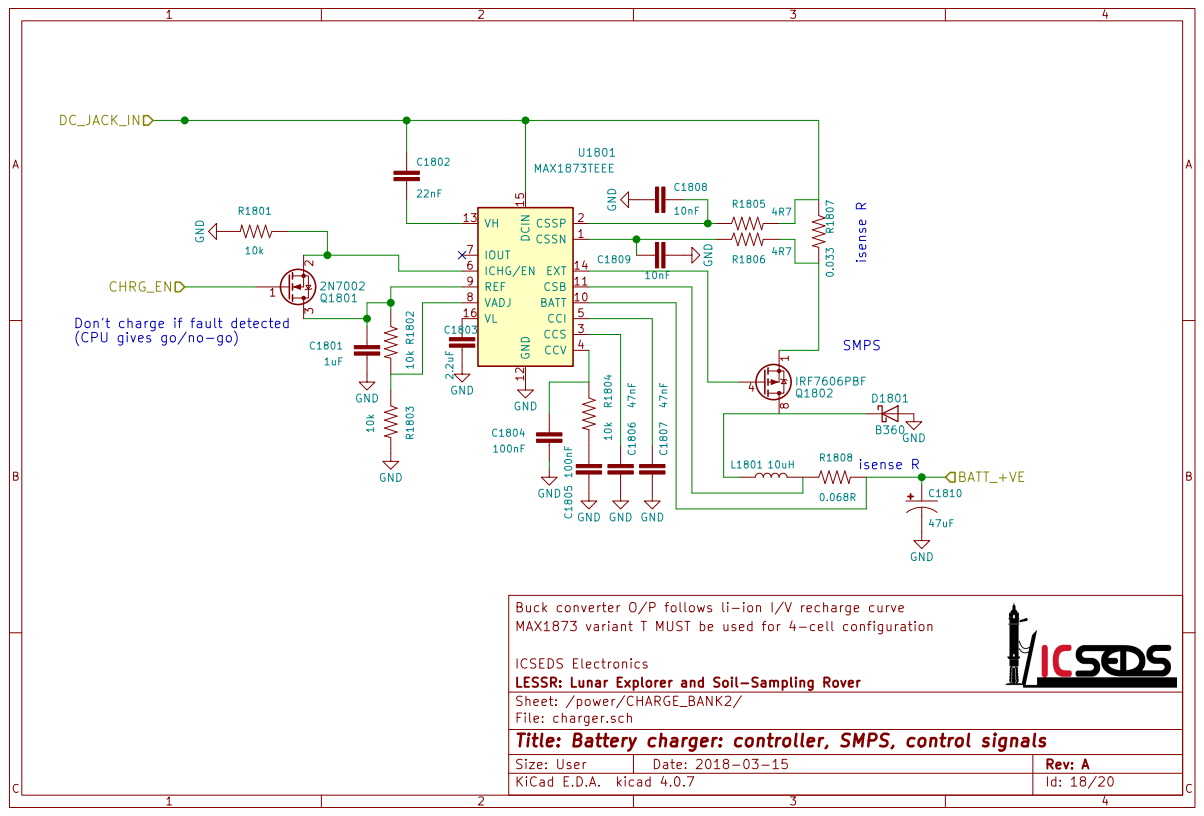
[picture p32: page 18]

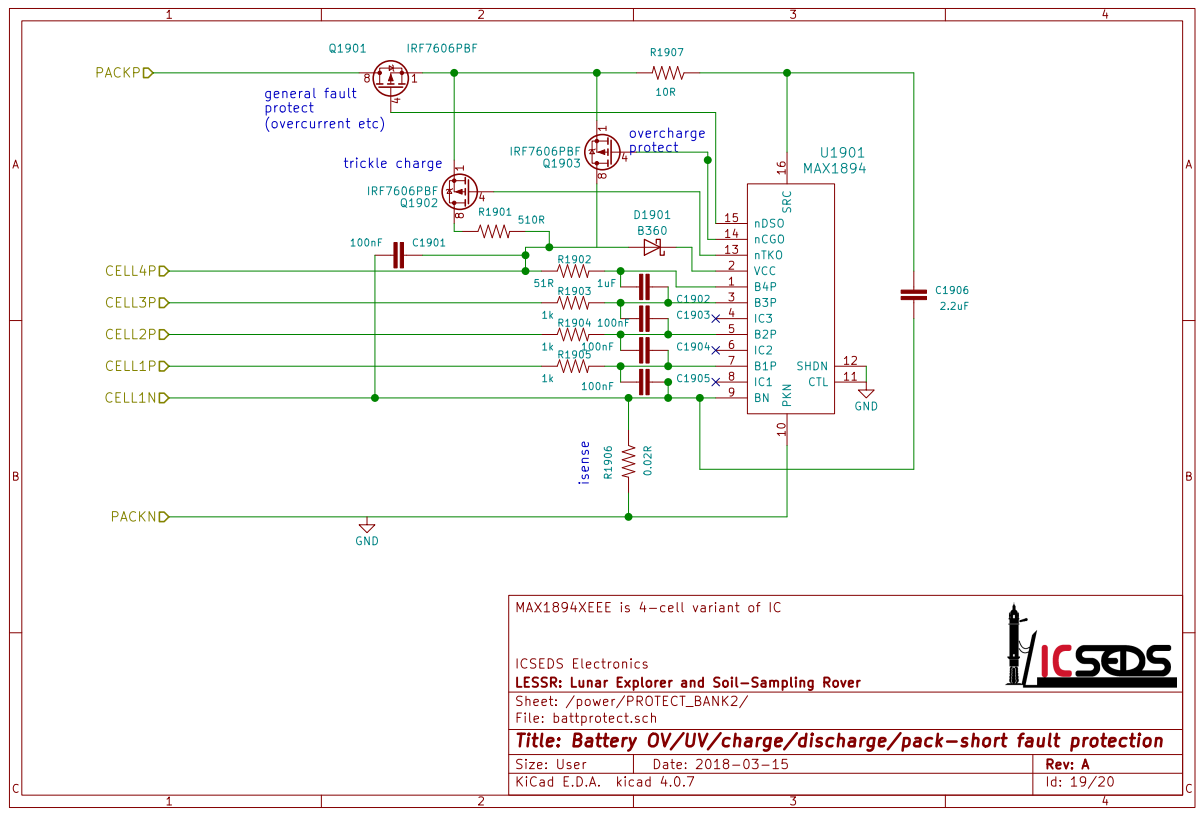
[picture p33: page 19]

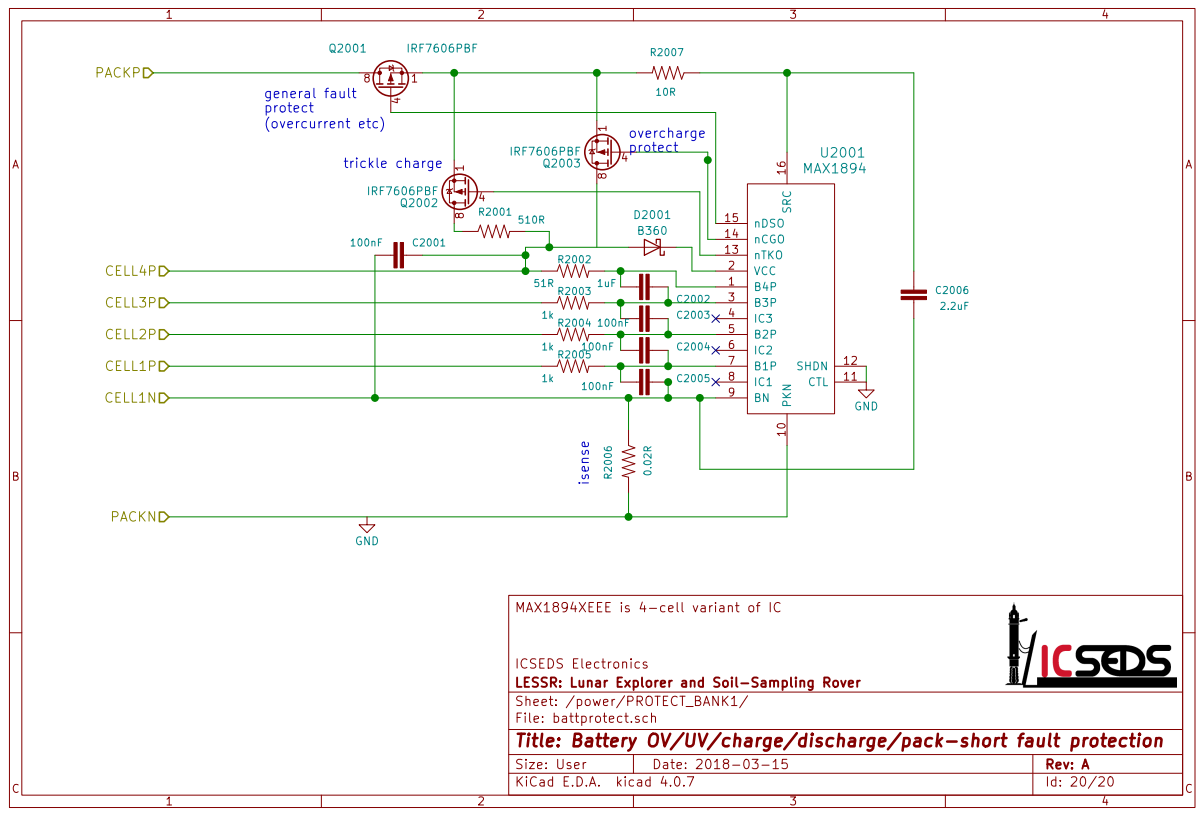
[picture p34: page 20]
