shaunfg/MarsRoverElectronics/Mars Rover.kicad_pcb

## KiCad design Mars Rover.kicad_pcb (2019-03-21)

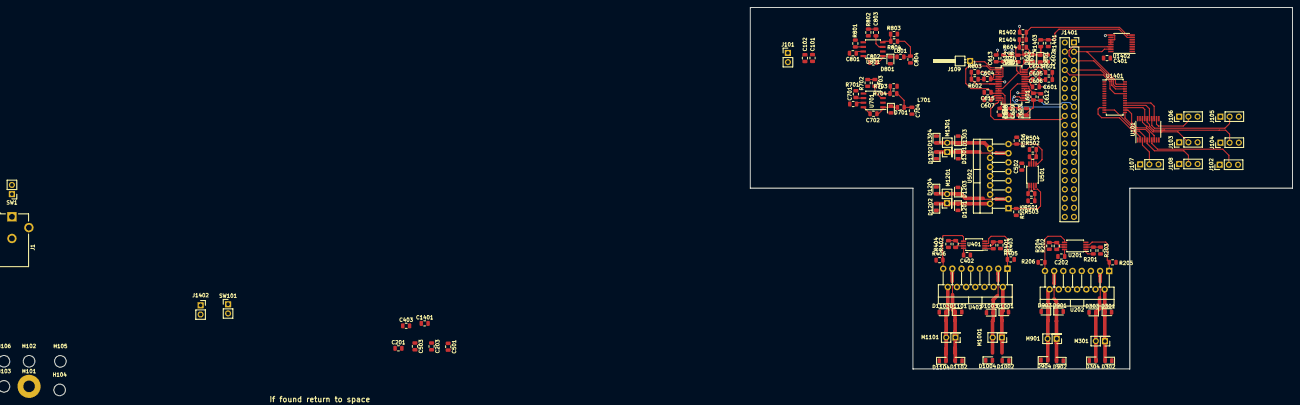
[picture p35: board Mars Rover.kicad_pcb from above]

Board: 2 copper layers, 150.0 x 100.0 mm, 141 parts (0 on the bottom side), 101 nets.

Parts:
C101, C614, C616: 22uF; C_0805_2012Metric
C102, C601, C602, C605, C606, C610, C611, C612: 0.1uF; C_0805_2012Metric
C201, C202, C203, C401, C402, C403, C501, C502, C503: 100nF; C_0805_2012Metric
C603, C607, C608: 1nF; C_0805_2012Metric
C604: 1uF; C_0805_2012Metric
C609, C701, C702, C801, C802, C1401: C; C_0805_2012Metric
C613: 0.22uF; C_0805_2012Metric
C615: 4.7uF; C_0805_2012Metric
C703, C704, C803, C804: 220pF; C_0805_2012Metric
D301, D302, D303, D304, D601, D604, D901, D902, D903, D904, D1001, D1002, D1003, D1004, D1101, D1102, D1103, D1104, D1201, D1202, D1203, D1204, D1301, D1302, D1303, D1304: DIODE; D_0805_2012Metric
D602, D603, D701, D801: D_Schottky; D_0805_2012Metric
H101: MountingHole_Pad; MountingHole_3.2mm_M3_Pad
H102, H103, H104, H105, H106: MountingHole; MountingHole_3.2mm_M3
J1: Barrel_Jack; BarrelJack_CUI_PJ-102AH_Horizontal
J101: Conn_01x02; PinHeader_1x02_P2.54mm_Vertical
J102, J103, J104, J105, J106, J107, J108: Conn_01x03; PinHeader_1x03_P2.54mm_Vertical
J109: Conn_01x01; PinHeader_1x01_P2.54mm_Horizontal
J1401: Raspberry_Pi_2_3; PinSocket_2x20_P2.54mm_Vertical
J1402: Conn_01x02; PinSocket_1x02_P2.54mm_Vertical
L601: INDUCTOR; L_0805_2012Metric
L701, L801: L; L_0805_2012Metric
M301, M901, M1001, M1101, M1201, M1301: Motor_DC; PinHeader_2x01_P2.54mm_Vertical
R201, R202, R401, R402, R501, R502: 1k; R_0805_2012Metric
R203, R204, R403, R404, R503, R504, R601, R703, R803: 10k; R_0805_2012Metric
R205, R206, R405, R406, R505, R506: 200mR; R_0805_2012Metric
R602, R603, R1401, R1402, R1403, R1404: R; R_0805_2012Metric
R604: 0.05R; R_0805_2012Metric
R701, R801: 200k; R_0805_2012Metric
R702, R802: 68k; R_0805_2012Metric
R704: 51k; R_0805_2012Metric
R804: 75k; R_0805_2012Metric
SW1: KILLSWITCH; PinHeader_1x02_P2.54mm_Vertical
SW101: CHARGING; PinHeader_1x02_P2.54mm_Vertical
U101: 74HCT244; TSSOP-20_4.4x6.5mm_P0.65mm
U201, U401, U501: OP279; TSSOP-8_4.4x3mm_P0.65mm
U202, U402, U502: L298HN; TO-220-15_P2.54x2.54mm_StaggerOdd_Lead4.58mm_Vertical
U601: MAX1758; SSOP-28_5.3x10.2mm_P0.65mm
U701, U801: MP2467; SOIC-8_3.9x4.9mm_P1.27mm
U1401: PCA9685PW; TSSOP-28_4.4x9.7mm_P0.65mm
U1402: ADS7828; TSSOP-16_4.4x5mm_P0.65mm

Connections:
+3V3: J1401.1, J1401.17
+5V: C201.2, C202.1, C401.2, C402.1, C501.2, C502.1, C704.1, C1401.1, J1401.2, J1401.4, J1402.1, L701.2, R704.2, U201.8, U202.6, U202.9, U202.11, U401.8, U402.6, U402.9, U402.11, U501.8, U502.6, U502.9, U502.11, U1401.28, U1402.16
+7.5V: C804.1, J102.3, J103.3, J104.3, J105.3, J106.3, J107.3, J108.3, L801.2, R804.2, U101.20
+12V: C203.2, C403.2, C503.2, C801.1, D301.2, D303.2, D901.2, D903.2, D1001.2, D1003.2, D1101.2, D1103.2, D1201.2, D1203.2, D1301.2, D1303.2, SW101.2, U202.4, U402.4, U502.4, U801.7
/Battery Connection and Charge Management/BATT: C101.1, C102.2, J101.2, U601.8
/Battery Connection and Charge Management/CHRG_VL: C615.1, D604.1, U601.1, U601.11
/Battery Connection and Charge Management/THERM: J109.1, U601.4
/Battery Connection and Charge Management/~FASTCHRG: J1401.15, U601.15
/Battery Connection and Charge Management/~FAULT: J1401.18, U601.14
/Battery Connection and Charge Management/~FULLCHRG: J1401.16, U601.16
/Digital logic/HK0: R201.1, U201.1, U1402.1
/Digital logic/HK1: R202.1, U201.7, U1402.2
/Digital logic/HK2: R401.1, U401.1, U1402.3
/Digital logic/HK3: R402.1, U401.7, U1402.4
/Digital logic/HK4: R501.1, U501.1, U1402.5
/Digital logic/HK5: R502.1, U501.7, U1402.6
/Digital logic/POL0: J1401.35, U202.7
/Digital logic/POL1: J1401.38, U202.12
/Digital logic/POL2: J1401.40, U402.7
/Digital logic/POL3: J1401.36, U402.12
/Digital logic/POL4: J1401.27, U502.7
/Digital logic/POL5: J1401.28, U502.12
/Digital logic/PWM0: U202.5, U1401.6
/Digital logic/PWM1: U202.10, U1401.7
/Digital logic/PWM2: U402.5, U1401.8
/Digital logic/PWM3: U402.10, U1401.9
/Digital logic/PWM4: U502.5, U1401.10
/Digital logic/PWM5: U502.10, U1401.11
/Digital logic/PWM6: U101.2, U1401.12
/Digital logic/PWM7: U101.4, U1401.13
/Digital logic/PWM8: U101.6, U1401.15
/Digital logic/PWM9: U101.8, U1401.16
/Digital logic/PWMA: U101.17, U1401.17
/Digital logic/PWMB: U101.15, U1401.18
/Digital logic/PWMC: U101.13, U1401.19
/Digital logic/SCL: J1401.5, U1401.26, U1402.14
/Digital logic/SDA: J1401.3, U1401.27, U1402.15
/Digital logic/~OE: J1401.8, U1401.23
/Motor/V1: D301.1, D302.2, M301.1, U202.2
/Motor/V2: D303.1, D304.2, M301.2, U202.3
/VIN_RAW: D601.1, D602.2, R1403.1, SW1.2
/VMOTOR: C610.2, C613.1, C614.1, C616.1, C701.1, R604.2, R1404.2, SW101.1, U601.9, U601.10, U601.26, U701.7
/sheet5C45D717/V1: D901.1, D902.2, M901.1, U202.13
/sheet5C45D717/V2: D903.1, D904.2, M901.2, U202.14
/sheet5C45DA5C/V1: D1001.1, D1002.2, M1001.1, U402.2
/sheet5C45DA5C/V2: D1003.1, D1004.2, M1001.2, U402.3
/sheet5C45DEF9/V1: D1101.1, D1102.2, M1101.1, U402.13
/sheet5C45DEF9/V2: D1103.1, D1104.2, M1101.2, U402.14
/sheet5C45F77A/V1: D1201.1, D1202.2, M1201.1, U502.2
/sheet5C45F77A/V2: D1203.1, D1204.2, M1201.2, U502.3
/sheet5C45FA3C/V1: D1301.1, D1302.2, M1301.1, U502.13
/sheet5C45FA3C/V2: D1303.1, D1304.2, M1301.2, U502.14
GND: C101.2, C102.1, C201.1, C202.2, C203.1, C401.1, C402.2, C403.1, C501.1, C502.2, C503.1, C601.2, C602.1, C603.2, C604.1, C605.2, C606.2, C607.2, C608.2, C610.1, C611.1, C612.2, C613.2, C614.2, C615.2, C616.2, C701.2, C704.2, C801.2, C804.2, C1401.2, D302.1, D304.1, D603.2, D701.2, D801.2, D902.1, D904.1, D1002.1, D1004.1, D1102.1, D1104.1, D1202.1, D1204.1, D1302.1, D1304.1, H101.1, J1.2, J101.1, J102.1, J103.1, J104.1, J105.1, J106.1, J107.1, J108.1, J1401.6, J1401.9, J1401.14, J1401.20, J1401.25, J1401.30, J1401.34, J1401.39, J1402.2, R203.2, R204.2, R205.2, R206.2, R403.2, R404.2, R405.2, R406.2, R503.2, R504.2, R505.2, R506.2, R602.2, R701.1, R702.2, R703.1, R801.1, R802.2, R803.1, R1401.2, R1402.2, U101.1, U101.10, U101.19, U201.4, U202.8, U401.4, U402.8, U501.4, U502.8, U601.6, U601.18, U701.5, U801.5, U1401.1, U1401.2, U1401.3, U1401.4, U1401.5, U1401.14, U1401.24, U1402.9, U1402.11, U1402.12, U1402.13
unnamed: C601.1, R601.2
unnamed: C602.2, D601.2, U601.28
unnamed: C603.1, R601.1, U601.25
unnamed: C604.2, R603.2, U601.2, U601.3, U601.5
unnamed: C605.1, U601.24
unnamed: C606.1, U601.23
unnamed: C607.1, U601.12
unnamed: C608.1, U601.13
unnamed: C609.1, D603.1, L601.1, U601.19, U601.20
unnamed: C609.2, D604.2, U601.22
unnamed: C611.2, D602.1, R604.1, U601.27
unnamed: C612.1, L601.2, U601.21
unnamed: C702.1, U701.8
unnamed: C702.2, D701.1, L701.1, U701.1
unnamed: C703.1, U701.3
unnamed: C703.2, R702.1
unnamed: C802.1, U801.8
unnamed: C802.2, D801.1, L801.1, U801.1
unnamed: C803.1, U801.3
unnamed: C803.2, R802.1
unnamed: J1.1, SW1.1
unnamed: J102.2, U101.7
unnamed: J103.2, U101.18
unnamed: J104.2, U101.16
unnamed: J105.2, U101.14
unnamed: J106.2, U101.12
unnamed: J107.2, U101.3
unnamed: J108.2, U101.5
unnamed: J1401.7, U1401.25
unnamed: R201.2, R203.1, U201.2
unnamed: R202.2, R204.1, U201.6
unnamed: R205.1, U201.3, U202.1
unnamed: R206.1, U201.5, U202.15
unnamed: R401.2, R403.1, U401.2
unnamed: R402.2, R404.1, U401.6
unnamed: R405.1, U401.3, U402.1
unnamed: R406.1, U401.5, U402.15
unnamed: R501.2, R503.1, U501.2
unnamed: R502.2, R504.1, U501.6
unnamed: R505.1, U501.3, U502.1
unnamed: R506.1, U501.5, U502.15
unnamed: R602.1, R603.1, U601.7
unnamed: R701.2, U701.6
unnamed: R703.2, R704.1, U701.4
unnamed: R801.2, U801.6
unnamed: R803.2, R804.1, U801.4
unnamed: R1401.1, R1403.2, U1402.7
unnamed: R1402.1, R1404.1, U1402.8
