shaunfg/MarsRoverElectronics/old-rover/lessr/Rover.kicad_pcb

## KiCad design old-rover/lessr/Rover.kicad_pcb (2018-12-06, an earlier design)

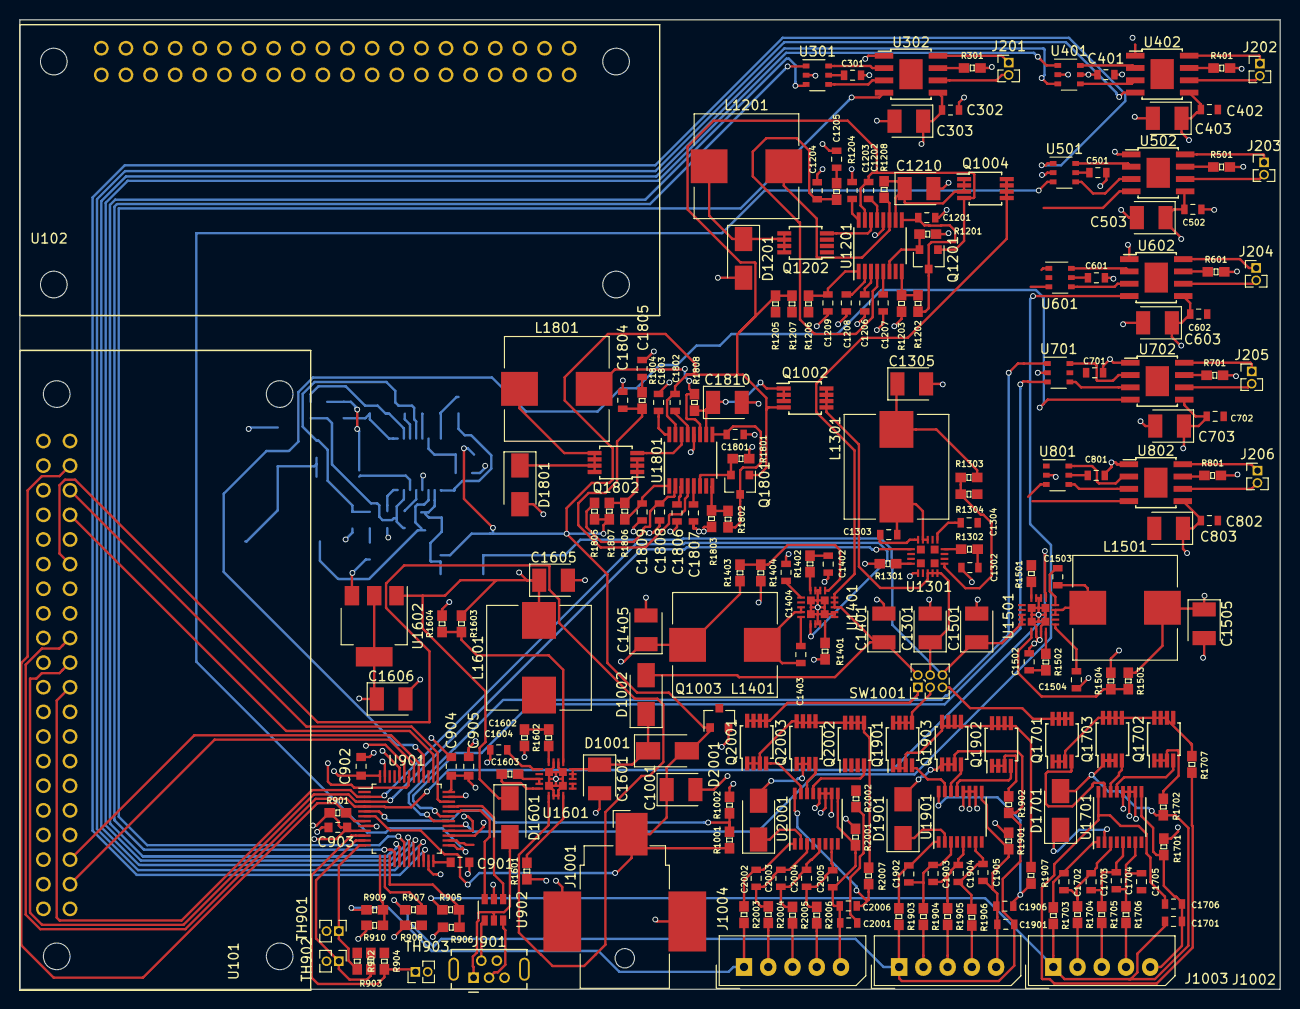
[picture p36: board Rover.kicad_pcb from above]

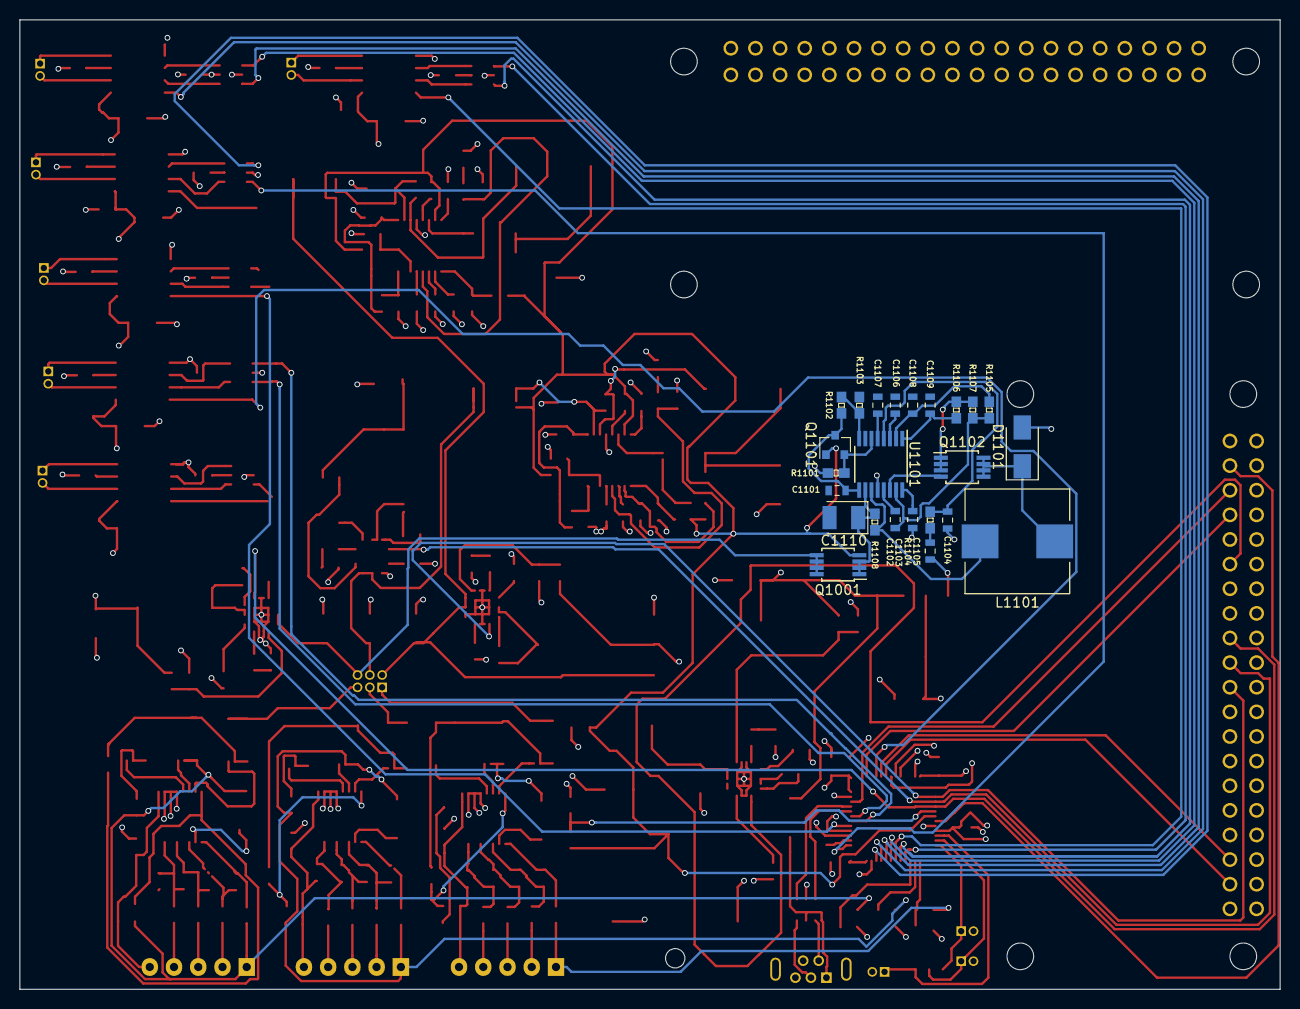
[picture p37: board Rover.kicad_pcb from below]

Board: 4 copper layers, 130.0 x 100.0 mm, 249 parts (24 on the bottom side), 208 nets.

Parts:
C301, C401, C501, C601, C701, C801, C1104, C1105, C1204, C1205, C1303, C1403, C1503, C1701, C1703, C1704, C1705, C1804, C1805, C1901, C1903, C1904, C1905, C2001, C2003, C2004, C2005: 100nF; C_0603_1608Metric
C302, C402, C502, C602, C702, C802: 10uF; C_0603_1608Metric
C303, C403, C503, C603, C703, C803, C1001, C1110, C1210, C1301, C1305, C1401, C1405, C1501, C1505, C1601, C1605, C1606, C1810: 22uF; CP_EIA-3528-21_Kemet-B
C901, C902, C903, C904: 100nF; C_0603_1608Metric_Pad0.84x1.00mm_HandSolder
C905: 1uF; C_0603_1608Metric_Pad0.84x1.00mm_HandSolder
C1101, C1201, C1702, C1801, C1902, C2002: 1uF; C_0603_1608Metric
C1102, C1202, C1802: 22nF; C_0603_1608Metric
C1103, C1203, C1706, C1803, C1906, C2006: 2.2uF; C_0603_1608Metric
C1106, C1107, C1206, C1207, C1806, C1807: 47nF; C_0603_1608Metric
C1108, C1109, C1208, C1209, C1302, C1304, C1402, C1404, C1502, C1504, C1604, C1808, C1809: 10nF; C_0603_1608Metric
C1602: 10nF; 0603
C1603: 100nF; 0603
D1001, D1002, D1101, D1201, D1601, D1701, D1801, D1901, D2001: B360; D_SMA
J201, J202, J203, J204, J205, J206: Conn_01x02; PinHeader_1x02_P1.27mm_Vertical
J901: USB_B_Micro; USB_Micro-B_Tensility_54-00023_Vertical
J1001: Jack-DC; BarrelJack_CUI_PJ-036AH-SMT_Horizontal
J1002, J1003, J1004: Conn_01x05; Molex_SPOX_5267-05A_1x05_P2.50mm_Vertical
L1101, L1201, L1301, L1401, L1501, L1601, L1801: 10uH; L_Wuerth_HCI-1030
Q1001, Q1002, Q1004, Q1102, Q1202, Q1701, Q1702, Q1703, Q1802, Q1901, Q1902, Q1903, Q2001, Q2002, Q2003: IRF7606PBF; MSOP-8_3x3mm_P0.65mm
Q1003, Q1101, Q1201, Q1801: 2N7002; SOT-23
R301, R401, R501, R601, R701, R801: 0.22R; 0603
R901, R1101, R1104, R1201, R1204, R1304, R1404, R1504, R1604, R1801, R1804: 10k; 0603
R902, R903, R904: 500R; 0603
R905, R907, R909: 120k; 0603
R906, R908, R910: 20k; 0603
R1001, R1102, R1103, R1202, R1203, R1802, R1803: 100k; 0603
R1002: 15k; 0603
R1105, R1106, R1205, R1206, R1805, R1806: 4R7; 0603
R1107, R1207, R1807: 0.033R; 0603
R1108, R1208, R1808: 0.068R; 0603
R1301, R1401, R1501, R1601: 29k; 0603
R1302, R1402, R1502, R1602: 1k7; 0603
R1303, R1403, R1503: 140k; 0603
R1603: 52k5; 0603
R1701, R1901, R2001: 0.02R; 0603
R1702, R1902, R2002: 510R; 0603
R1703, R1903, R2003: 51R; 0603
R1704, R1705, R1706, R1904, R1905, R1906, R2004, R2005, R2006: 1k; 0603
R1707, R1907, R2007: 10R; 0603
SW1001: SW_DIP_x03; PinHeader_2x03_P1.27mm_Vertical
TH901, TH902, TH903: KTY81; PinHeader_1x02_P1.27mm_Vertical
U101, U102: Rpi0w; raspi0w
U301, U401, U501, U601, U701, U801: 74LVC1G18GW; TSOP-6_1.65x3.05mm_P0.95mm
U302, U402, U502, U602, U702, U802: DRV8872-Q1; TI_SO-PowerPAD-8
U901: STM32F042C4Tx; LQFP-48_7x7mm_P0.5mm
U902: USBLC6; SOT-23-6
U1101, U1201, U1801: MAX1873TEEE; QSOP-16_3.9x4.9mm_P0.635mm
U1301, U1401, U1501, U1601: TPS54620; TPS54610
U1602: LM1117MPX-3.3/NOPB; SOT-223-3_TabPin2
U1701, U1901, U2001: MAX1894; SSOP-16_3.9x4.9mm_P0.635mm

Connections:
+3V3: R902.1, R903.1, R904.1
+12V: C302.1, C303.1, C402.1, C403.1, C502.1, C503.1, C602.1, C603.1, C702.1, C703.1, C802.1, C803.1, C1305.1, C1405.1, C1505.1, L1301.2, L1401.2, L1501.2, R1303.1, R1403.1, R1503.1, U302.5, U402.5, U502.5, U602.5, U702.5, U802.5
/CPU/3V3: C301.1, C401.1, C501.1, C601.1, C701.1, C801.1, C901.1, C902.1, C903.1, C904.1, C905.1, C1606.1, R901.1, U301.5, U401.5, U501.5, U601.5, U701.5, U801.5, U901.9, U901.24, U901.36, U901.48, U1602.2
/CPU/BANK1_GD: U101.23, U901.4, U1501.14
/CPU/BANK1_V: C2001.2, D2001.2, J1004.1, Q2003.1, Q2003.2, Q2003.3, R909.1, R2002.1, R2003.2
/CPU/BANK2_GD: U101.21, U901.3, U1301.14
/CPU/BANK2_V: C1901.2, D1901.2, J1003.1, Q1903.1, Q1903.2, Q1903.3, R907.1, R1902.1, R1903.2
/CPU/BANK3_GD: U101.19, U901.2, U1401.14
/CPU/BANK3_V: C1701.2, D1701.2, J1002.1, Q1703.1, Q1703.2, Q1703.3, R905.1, R1702.1, R1703.2
/CPU/CHARGE_OK: C1001.1, C1202.1, C1802.1, D1001.2, J1001.1, Q1001.4, Q1002.4, Q1003.1, Q1004.4, Q1101.1, Q1201.1, Q1801.1, R1001.1, R1205.1, R1207.2, R1805.1, R1807.2, U901.6, U1201.15, U1801.15
/CPU/DC_CONN: R1001.2, R1002.1, U901.5
/CPU/EXT_N: J901.2, U902.4
/CPU/EXT_P: J901.3, U902.6
/CPU/I2C_SCL: U101.5, U901.40
/CPU/I2C_SDA: U101.3, U901.41
/CPU/INT_N: U901.32, U902.3
/CPU/INT_P: U901.33, U902.1
/CPU/MOT0_POL: U301.1, U901.16
/CPU/MOT0_PWM: U301.3, U901.17
/CPU/MOT0_nFAULT: U302.4, U901.18
/CPU/MOT1_POL: U401.1, U901.19
/CPU/MOT1_PWM: U401.3, U901.20
/CPU/MOT1_nFAULT: U402.4, U901.21
/CPU/MOT2_POL: U501.1, U901.22
/CPU/MOT2_PWM: U501.3, U901.25
/CPU/MOT2_nFAULT: U502.4, U901.26
/CPU/MOT3_POL: U601.1, U901.27
/CPU/MOT3_PWM: U601.3, U901.28
/CPU/MOT3_nFAULT: U602.4, U901.29
/CPU/SWCLK: U101.33, U901.37
/CPU/SWDIO: U101.35, U901.34
/CPU/SWEEP_POL: U701.1, U901.30
/CPU/SWEEP_PWM: U701.3, U901.31
/CPU/SWEEP_nFAULT: U702.4, U901.39
/CPU/TRAY_POL: U801.1, U901.42
/CPU/TRAY_PWM: U801.3, U901.43
/CPU/TRAY_nFAULT: U802.4, U901.44
/CPU/V_USB: D1601.2, J901.1, U902.5
/CPU/nRST: R901.2, U101.37, U901.7
/motordrive/MOT0_DRV/MOTL: J201.1, U302.8
/motordrive/MOT0_DRV/MOTR: J201.2, U302.6
/motordrive/MOT1_DRV/MOTL: J202.1, U402.8
/motordrive/MOT1_DRV/MOTR: J202.2, U402.6
/motordrive/MOT2_DRV/MOTL: J203.1, U502.8
/motordrive/MOT2_DRV/MOTR: J203.2, U502.6
/motordrive/MOT3_DRV/MOTL: J204.1, U602.8
/motordrive/MOT3_DRV/MOTR: J204.2, U602.6
/motordrive/SWEEP_DRV/MOTL: J205.1, U702.8
/motordrive/SWEEP_DRV/MOTR: J205.2, U702.6
/motordrive/TRAY_DRV/MOTL: J206.1, U802.8
/motordrive/TRAY_DRV/MOTR: J206.2, U802.6
/power/5V: C1605.1, D1601.1, L1601.2, R1603.1, U101.2, U101.4, U102.2, U102.4, U1602.1
/power/BUCK_12V_BANK1/EN: Q1003.3, U1301.10, U1401.10, U1501.10
/power/BUCK_12V_BANK1/V_BATT: C1401.1, D1002.2, Q1004.5, Q1004.6, Q1004.7, Q1004.8, SW1001.2, U1401.4, U1401.5, U1401.6
/power/BUCK_12V_BANK2/V_BATT: C1301.1, Q1002.5, Q1002.6, Q1002.7, Q1002.8, SW1001.4, U1301.4, U1301.5, U1301.6
/power/BUCK_12V_BANK3/V_BATT: C1501.1, Q1001.5, Q1001.6, Q1001.7, Q1001.8, SW1001.6, U1501.4, U1501.5, U1501.6
/power/BUCK_DVCC/V_BATT: C1601.1, D1001.1, D1002.1, U1601.4, U1601.5, U1601.6
/power/CHARGE_BANK1/BATT_+VE: C1210.1, Q1004.1, Q1004.2, Q1004.3, R1208.1, U1201.10
/power/CHARGE_BANK2/BATT_+VE: C1810.1, Q1002.1, Q1002.2, Q1002.3, R1808.1, U1801.10
/power/CHARGE_BANK3/BATT_+VE: C1110.1, Q1001.1, Q1001.2, Q1001.3, R1108.1, U1101.10
/power/CHARGE_BANK3/DC_JACK_IN: C1102.1, R1105.1, R1107.2, U1101.15
/power/DIGI_GOOD: U101.29, U1601.14
/power/PROTECT_BANK1/CELL1N: C2001.1, C2005.1, C2006.1, J1004.5, R2001.2, U2001.9
/power/PROTECT_BANK1/CELL1P: J1004.4, R2006.2
/power/PROTECT_BANK1/CELL2P: J1004.3, R2005.2
/power/PROTECT_BANK1/CELL3P: J1004.2, R2004.2
/power/PROTECT_BANK1/PACKP: Q2001.5, Q2001.6, Q2001.7, Q2001.8, SW1001.1
/power/PROTECT_BANK2/CELL1N: C1901.1, C1905.1, C1906.1, J1003.5, R1901.2, U1901.9
/power/PROTECT_BANK2/CELL1P: J1003.4, R1906.2
/power/PROTECT_BANK2/CELL2P: J1003.3, R1905.2
/power/PROTECT_BANK2/CELL3P: J1003.2, R1904.2
/power/PROTECT_BANK2/PACKP: Q1901.5, Q1901.6, Q1901.7, Q1901.8, SW1001.3
/power/PROTECT_BANK3/CELL1N: C1701.1, C1705.1, C1706.1, J1002.5, R1701.2, U1701.9
/power/PROTECT_BANK3/CELL1P: J1002.4, R1706.2
/power/PROTECT_BANK3/CELL2P: J1002.3, R1705.2
/power/PROTECT_BANK3/CELL3P: J1002.2, R1704.2
/power/PROTECT_BANK3/PACKP: Q1701.5, Q1701.6, Q1701.7, Q1701.8, SW1001.5
GND: C301.2, C302.2, C303.2, C401.2, C402.2, C403.2, C501.2, C502.2, C503.2, C601.2, C602.2, C603.2, C701.2, C702.2, C703.2, C801.2, C802.2, C803.2, C901.2, C902.2, C903.2, C904.2, C905.2, C1001.2, C1101.1, C1103.1, C1104.1, C1105.1, C1106.1, C1107.1, C1108.1, C1109.1, C1110.2, C1201.1, C1203.1, C1204.1, C1205.1, C1206.1, C1207.1, C1208.1, C1209.1, C1210.2, C1301.2, C1302.1, C1304.1, C1305.2, C1401.2, C1402.1, C1404.1, C1405.2, C1501.2, C1502.1, C1504.1, C1505.2, C1601.2, C1602.1, C1604.1, C1605.2, C1606.2, C1801.1, C1803.1, C1804.1, C1805.1, C1806.1, C1807.1, C1808.1, C1809.1, C1810.2, D1101.2, D1201.2, D1801.2, J901.5, J901.6, J1001.2, J1001.3, Q1003.2, R301.2, R401.2, R501.2, R601.2, R701.2, R801.2, R906.2, R908.2, R910.2, R1002.2, R1101.2, R1103.2, R1201.2, R1203.2, R1301.1, R1304.2, R1401.1, R1404.2, R1501.1, R1504.2, R1601.1, R1604.2, R1701.1, R1801.2, R1803.2, R1901.1, R2001.1, TH901.2, TH902.2, TH903.2, U101.6, U101.9, U101.14, U101.20, U101.25, U101.34, U101.39, U102.6, U102.9, U102.14, U102.20, U102.25, U102.30, U102.34, U102.39, U301.2, U302.1, U401.2, U402.1, U501.2, U502.1, U601.2, U602.1, U701.2, U702.1, U801.2, U802.1, U901.8, U901.23, U901.35, U901.47, U902.2, U1101.12, U1201.12, U1301.2, U1301.3, U1301.15, U1401.2, U1401.3, U1401.15, U1501.2, U1501.3, U1501.15, U1601.2, U1601.3, U1601.15, U1602.3, U1701.10, U1701.11, U1701.12, U1801.12, U1901.10, U1901.11, U1901.12, U2001.10, U2001.11, U2001.12
unnamed: C1101.2, Q1101.3, R1102.1, U1101.9
unnamed: C1102.2, U1101.13
unnamed: C1103.2, U1101.16
unnamed: C1104.2, R1104.1, U1101.4
unnamed: C1105.2, R1104.2
unnamed: C1106.2, U1101.3
unnamed: C1107.2, U1101.5
unnamed: C1108.2, R1105.2, U1101.2
unnamed: C1109.2, R1106.2, U1101.1
unnamed: C1201.2, Q1201.3, R1202.1, U1201.9
unnamed: C1202.2, U1201.13
unnamed: C1203.2, U1201.16
unnamed: C1204.2, R1204.1, U1201.4
unnamed: C1205.2, R1204.2
unnamed: C1206.2, U1201.3
unnamed: C1207.2, U1201.5
unnamed: C1208.2, R1205.2, U1201.2
unnamed: C1209.2, R1206.2, U1201.1
unnamed: C1302.2, R1302.2
unnamed: C1303.1, L1301.1, U1301.11, U1301.12
unnamed: C1303.2, U1301.13
unnamed: C1304.2, U1301.9
unnamed: C1402.2, R1402.2
unnamed: C1403.1, L1401.1, U1401.11, U1401.12
unnamed: C1403.2, U1401.13
unnamed: C1404.2, U1401.9
unnamed: C1502.2, R1502.2
unnamed: C1503.1, L1501.1, U1501.11, U1501.12
unnamed: C1503.2, U1501.13
unnamed: C1504.2, U1501.9
unnamed: C1602.2, R1602.2
unnamed: C1603.1, L1601.1, U1601.11, U1601.12
unnamed: C1603.2, U1601.13
unnamed: C1604.2, U1601.9
unnamed: C1702.1, C1703.2, R1704.1, U1701.3
unnamed: C1702.2, R1703.1, U1701.1
unnamed: C1703.1, C1704.2, R1705.1, U1701.5
unnamed: C1704.1, C1705.2, R1706.1, U1701.7
unnamed: C1706.2, R1707.1, U1701.16
unnamed: C1801.2, Q1801.3, R1802.1, U1801.9
unnamed: C1802.2, U1801.13
unnamed: C1803.2, U1801.16
unnamed: C1804.2, R1804.1, U1801.4
unnamed: C1805.2, R1804.2
unnamed: C1806.2, U1801.3
unnamed: C1807.2, U1801.5
unnamed: C1808.2, R1805.2, U1801.2
unnamed: C1809.2, R1806.2, U1801.1
unnamed: C1902.1, C1903.2, R1904.1, U1901.3
unnamed: C1902.2, R1903.1, U1901.1
unnamed: C1903.1, C1904.2, R1905.1, U1901.5
unnamed: C1904.1, C1905.2, R1906.1, U1901.7
unnamed: C1906.2, R1907.1, U1901.16
unnamed: C2002.1, C2003.2, R2004.1, U2001.3
unnamed: C2002.2, R2003.1, U2001.1
unnamed: C2003.1, C2004.2, R2005.1, U2001.5
unnamed: C2004.1, C2005.2, R2006.1, U2001.7
unnamed: C2006.2, R2007.1, U2001.16
unnamed: D1101.1, L1101.1, Q1102.5, Q1102.6, Q1102.7, Q1102.8
unnamed: D1201.1, L1201.1, Q1202.5, Q1202.6, Q1202.7, Q1202.8
unnamed: D1701.1, U1701.2
unnamed: D1801.1, L1801.1, Q1802.5, Q1802.6, Q1802.7, Q1802.8
unnamed: D1901.1, U1901.2
unnamed: D2001.1, U2001.2
unnamed: L1101.2, R1108.2, U1101.11
unnamed: L1201.2, R1208.2, U1201.11
unnamed: L1801.2, R1808.2, U1801.11
unnamed: Q1101.2, R1101.1, U1101.6
unnamed: Q1102.1, Q1102.2, Q1102.3, R1106.1, R1107.1
unnamed: Q1102.4, U1101.14
unnamed: Q1201.2, R1201.1, U1201.6
unnamed: Q1202.1, Q1202.2, Q1202.3, R1206.1, R1207.1
unnamed: Q1202.4, U1201.14
unnamed: Q1701.1, Q1701.2, Q1701.3, Q1702.5, Q1702.6, Q1702.7, Q1702.8, Q1703.5, Q1703.6, Q1703.7, Q1703.8, R1707.2
unnamed: Q1701.4, U1701.15
unnamed: Q1702.1, Q1702.2, Q1702.3, R1702.2
unnamed: Q1702.4, U1701.13
unnamed: Q1703.4, U1701.14
unnamed: Q1801.2, R1801.1, U1801.6
unnamed: Q1802.1, Q1802.2, Q1802.3, R1806.1, R1807.1
unnamed: Q1802.4, U1801.14
unnamed: Q1901.1, Q1901.2, Q1901.3, Q1902.5, Q1902.6, Q1902.7, Q1902.8, Q1903.5, Q1903.6, Q1903.7, Q1903.8, R1907.2
unnamed: Q1901.4, U1901.15
unnamed: Q1902.1, Q1902.2, Q1902.3, R1902.2
unnamed: Q1902.4, U1901.13
unnamed: Q1903.4, U1901.14
unnamed: Q2001.1, Q2001.2, Q2001.3, Q2002.5, Q2002.6, Q2002.7, Q2002.8, Q2003.5, Q2003.6, Q2003.7, Q2003.8, R2007.2
unnamed: Q2001.4, U2001.15
unnamed: Q2002.1, Q2002.2, Q2002.3, R2002.2
unnamed: Q2002.4, U2001.13
unnamed: Q2003.4, U2001.14
unnamed: R301.1, U302.7
unnamed: R401.1, U402.7
unnamed: R501.1, U502.7
unnamed: R601.1, U602.7
unnamed: R701.1, U702.7
unnamed: R801.1, U802.7
unnamed: R902.2, TH901.1, U901.12
unnamed: R903.2, TH902.1, U901.11
unnamed: R904.2, TH903.1, U901.10
unnamed: R905.2, R906.1, U901.15
unnamed: R907.2, R908.1, U901.14
unnamed: R909.2, R910.1, U901.13
unnamed: R1102.2, R1103.1, U1101.8
unnamed: R1202.2, R1203.1, U1201.8
unnamed: R1301.2, U1301.1
unnamed: R1302.1, U1301.8
unnamed: R1303.2, R1304.1, U1301.7
unnamed: R1401.2, U1401.1
unnamed: R1402.1, U1401.8
unnamed: R1403.2, R1404.1, U1401.7
unnamed: R1501.2, U1501.1
unnamed: R1502.1, U1501.8
unnamed: R1503.2, R1504.1, U1501.7
unnamed: R1601.2, U1601.1
unnamed: R1602.1, U1601.8
unnamed: R1603.2, R1604.1, U1601.7
unnamed: R1802.2, R1803.1, U1801.8
unnamed: U301.4, U302.3
unnamed: U301.6, U302.2
unnamed: U401.4, U402.3
unnamed: U401.6, U402.2
unnamed: U501.4, U502.3
unnamed: U501.6, U502.2
unnamed: U601.4, U602.3
unnamed: U601.6, U602.2
unnamed: U701.4, U702.3
unnamed: U701.6, U702.2
unnamed: U801.4, U802.3
unnamed: U801.6, U802.2
