shaunfg/MarsRoverElectronics/(commit log)

2018-12-06 battery half done
    [12v_buck.sch, 3v3_buck.sch, CPU.sch, H-bridge.sch, Mars Rover.kicad_pcb, Mars Rover.sch, Rover.kicad_pcb, Rover.sch]
2018-12-06 Testing Commit
    [Mars Rover.sch, _saved_Mars Rover.sch]
2018-12-13 Battery Charger Done
    [Mars Rover.sch]
2019-01-17 Batteries done and raspi added
    [BattCon.sch, H-bridge.sch, Mars Rover.sch, buck.sch, buck_7v.sch, digital.sch, motor.sch]
2019-01-25 Added housekeeping ADC, schematics almost done
    [H-bridge.sch, Mars Rover.sch, digital.sch]
2019-01-31 Schematics Done. Now need to do footprints
    [BattCon.sch, H-bridge.sch, Mars Rover.kicad_pcb, Mars Rover.sch, buck.sch, buck_7v.sch, digital.sch, motor.sch]
2019-02-14 Schematics done, now assigning footprints to do PCB Next
    [BattCon.sch, H-bridge.sch, Mars Rover.sch, buck.sch, buck_7v.sch, digital.sch, motor.sch]
2019-02-14 Assigning footprints
    [BattCon.sch, Mars Rover.sch, _saved_H-bridge.sch, _saved_Mars Rover.sch, _saved_digital.sch, buck.sch]
2019-02-14 on to pcbs
    [H-bridge.sch, Mars Rover.kicad_pcb, Mars Rover.sch, _saved_H-bridge.sch, _saved_Mars Rover.sch, _saved_digital.sch, buck_7v.sch, digital.sch]
2019-02-21 PCB - MAX 1758
    [Mars Rover.kicad_pcb]
2019-02-21 More layout
    [Mars Rover.kicad_pcb]
2019-03-14 updated layout
    [BattCon.sch, H-bridge.sch, Mars Rover.kicad_pcb, Mars Rover.sch, buck.sch, buck_7v.sch, digital.sch]
2019-03-21 Fixed Courtyard violations and moved diodes away from motor screw terminals
    [Mars Rover.kicad_pcb]
